AlejandroRuiz444/-nexus32-esp32-pcb/Documentation/CUMPLIMIENTO_REQUISITOS.md

# NEXUS32 — Cumplimiento de requisitos (3/11/2026)

Estado de los 108 requisitos de `planificacion\01_TRAZABILIDAD_requisitos.csv`. **EN DISEÑO** quiere decir que el diseño lo implementa según los documentos de F1 a F3 y **no se re-verificó en esta sesión**; solo CUMPLE lleva una evidencia que se puede citar.

| Estado | Requisitos |
|---|---|
| EN DISEÑO | 64 |
| PARCIAL | 15 |
| CUMPLE | 9 |
| CUMPLE CON EXCEPCIÓN | 9 |
| ABIERTO | 9 |
| NO COMPROBADO | 1 |
| RESUELTO | 1 |
| **Total** | **108** |

| ID | Requisito | Tipo | Estado | Razón o evidencia |
|---|---|---|---|---|
| REQ-001 | El sistema debe poder medir señales procedentes de sensores (§1, p.1) | funcional | **EN DISEÑO** | El diseño lo implementa según 02_ANALISIS_CIRCUITO.md, Q1_esfuerzos.md y las hojas de F3; no re-verificado en esta sesión. ERC: 55 avisos justificados uno a uno (D-18, Q4_erc.md); «0 errores» sin confirmar en el panel Messages |
| REQ-002 | registrar eventos con fecha y hora (§1, p.1) | funcional | **EN DISEÑO** | El diseño lo implementa según 02_ANALISIS_CIRCUITO.md, Q1_esfuerzos.md y las hojas de F3; no re-verificado en esta sesión. ERC: 55 avisos justificados uno a uno (D-18, Q4_erc.md); «0 errores» sin confirmar en el panel Messages |
| REQ-003 | comunicar información tanto por red cableada como por radio (§1, p.1) | funcional | **EN DISEÑO** | El diseño lo implementa según 02_ANALISIS_CIRCUITO.md, Q1_esfuerzos.md y las hojas de F3; no re-verificado en esta sesión. ERC: 55 avisos justificados uno a uno (D-18, Q4_erc.md); «0 errores» sin confirmar en el panel Messages |
| REQ-004 | actuar sobre dos dispositivos externos (§1, p.1) | funcional | **EN DISEÑO** | El diseño lo implementa según 02_ANALISIS_CIRCUITO.md, Q1_esfuerzos.md y las hojas de F3; no re-verificado en esta sesión. ERC: 55 avisos justificados uno a uno (D-18, Q4_erc.md); «0 errores» sin confirmar en el panel Messages |
| REQ-005 | supervisarse localmente (§1, p.1) | funcional | **EN DISEÑO** | P-10 cerrado el 3/11 (orden de pines GND-VCC-SCL-SDA = J3). Solo dependía del cableado; el ERC sigue como verificación |
| REQ-006 | conservar parámetros después de fallos de alimentación (§1, p.1) | funcional | **EN DISEÑO** | El diseño lo implementa según 02_ANALISIS_CIRCUITO.md, Q1_esfuerzos.md y las hojas de F3; no re-verificado en esta sesión. ERC: 55 avisos justificados uno a uno (D-18, Q4_erc.md); «0 errores» sin confirmar en el panel Messages |
| REQ-007 | módulo compacto, modular, mantenible y documentado, apto para la fabricación de una PCB (§ | restricción | **CUMPLE** | Una sola PCB de 159,995 × 119,990 mm, 12 hojas por bloque y documentación en carpetas [VERIFICADO: Gerber GM, NEXUS32.PrjPcb] |
| REQ-008 | El desarrollo debe permitir evaluar cada interfaz digital por separado y posteriormente in | funcional | **CUMPLE** | 23 puntos de prueba (TP1–TP23) y puente de 0 Ω (R55) en la placa [VERIFICADO: PcbDoc y BOM] |
| REQ-009 | diseñar... una tarjeta... basada en ESP32, empleando I²C, SPI y UART (§2, p.1) | funcional | **EN DISEÑO** | El diseño lo implementa según 02_ANALISIS_CIRCUITO.md, Q1_esfuerzos.md y las hojas de F3; no re-verificado en esta sesión. ERC: 55 avisos justificados uno a uno (D-18, Q4_erc.md); «0 errores» sin confirmar en el panel Messages |
| REQ-010 | mediante subsistemas jerárquicos verificables (§2, p.1) | restricción | **EN DISEÑO** | El diseño lo implementa según 02_ANALISIS_CIRCUITO.md, Q1_esfuerzos.md y las hojas de F3; no re-verificado en esta sesión. ERC: 55 avisos justificados uno a uno (D-18, Q4_erc.md); «0 errores» sin confirmar en el panel Messages |
| REQ-011 | Interpretar fichas técnicas y derivar requisitos eléctricos, funcionales y mecánicos (§2.1 | entregable | **PARCIAL** | Las hojas de datos de DS1307 (Analog Devices) y MP1584 rev. 1.1 no se pudieron leer (acceso bloqueado): [PENDIENTE: A1, Fase 1] |
| REQ-012 | Desarrollar esquemáticos jerárquicos con conexiones consistentes y documentación de cada b | entregable | **PARCIAL** | Jerarquía y puertos cerrados en F3 (28/10). ERC: 55 avisos justificados, 0 errores sin confirmar en el panel Messages (D-18) |
| REQ-013 | Implementar periféricos I²C, SPI y UART con asignación de pines y compatibilidad eléctrica | funcional | **EN DISEÑO** | El diseño lo implementa según 02_ANALISIS_CIRCUITO.md, Q1_esfuerzos.md y las hojas de F3; no re-verificado en esta sesión. ERC: 55 avisos justificados uno a uno (D-18, Q4_erc.md); «0 errores» sin confirmar en el panel Messages |
| REQ-014 | Diseñar interfaces analógicas protegidas (§2.1, p.1) | funcional | **EN DISEÑO** | El diseño lo implementa según 02_ANALISIS_CIRCUITO.md, Q1_esfuerzos.md y las hojas de F3; no re-verificado en esta sesión. ERC: 55 avisos justificados uno a uno (D-18, Q4_erc.md); «0 errores» sin confirmar en el panel Messages |
| REQ-015 | alimentación dual (§2.1, p.1) | funcional | **EN DISEÑO** | Condicionado a P-03 (alimentación dual): pregunta al docente abierta; se usa el valor por defecto de 05_PREGUNTAS_DOCENTE.md |
| REQ-016 | conectividad física y dos salidas por relé (§2.1, p.1) | funcional | **EN DISEÑO** | El diseño lo implementa según 02_ANALISIS_CIRCUITO.md, Q1_esfuerzos.md y las hojas de F3; no re-verificado en esta sesión. ERC: 55 avisos justificados uno a uno (D-18, Q4_erc.md); «0 errores» sin confirmar en el panel Messages |
| REQ-017 | Construir librerías completas (§2.1, p.1) | entregable | **CUMPLE CON EXCEPCIÓN** | F2 cerrada: 44 símbolos y 38 huellas con STEP incrustado; desviaciones documentadas D-01 a D-13 (patrones IPC nominales, ranuras, NPTH) |
| REQ-018 | configurar reglas, clases de red/componente y restricciones de ruteo (§2.1, p.1) | entregable | **CUMPLE** | 50 reglas habilitadas [VERIFICADO: pcb_get_design_rules, F5_verificar_gui.py 14/14] y las clases de red (10 propias) y de componente (una por hoja) en el PcbDoc [VERIFICADO: Classes6] |
| REQ-019 | Generar y verificar documentación para fabricación y ensamble: Gerber, perforaciones, BOM  | entregable | **PARCIAL** | BORRADOR en NEXUS32\Manufacturing\BORRADOR_2026-11-03 (Gerber, taladros, IPC-356, STEP, BOM, CPL); el paquete final se genera tras el congelado |
| REQ-020 | Entrada de alimentación desde 24 VDC nominales o batería externa especificada (§3, p.1) | funcional | **EN DISEÑO** | Condicionado a P-03, P-08 y P-11 (preguntas abiertas con valor por defecto) |
| REQ-021 | conversión mediante MP1584EN y regulación adicional (§3, p.1) | funcional | **EN DISEÑO** | Condicionado a P-08: la fuente de 24 V debe ser ≤ 25 V para el OVP del MP1584EN; abierta |
| REQ-022 | Ocho canales analógicos mediante MCP3208 (§3, p.1) | funcional | **EN DISEÑO** | El diseño lo implementa según 02_ANALISIS_CIRCUITO.md, Q1_esfuerzos.md y las hojas de F3; no re-verificado en esta sesión. ERC: 55 avisos justificados uno a uno (D-18, Q4_erc.md); «0 errores» sin confirmar en el panel Messages |
| REQ-023 | cuatro previstos para 0–10 V (§3, p.1) | funcional | **EN DISEÑO** | Condicionado a P-06 (impedancia de entrada y protección de 0–10 V): abierta, con valor por defecto |
| REQ-024 | y cuatro para 0–3,3 V (§3, p.1) | funcional | **EN DISEÑO** | El diseño lo implementa según 02_ANALISIS_CIRCUITO.md, Q1_esfuerzos.md y las hojas de F3; no re-verificado en esta sesión. ERC: 55 avisos justificados uno a uno (D-18, Q4_erc.md); «0 errores» sin confirmar en el panel Messages |
| REQ-025 | con acondicionamiento, filtrado y protección apropiados (§3, p.1) | funcional | **EN DISEÑO** | El diseño lo implementa según 02_ANALISIS_CIRCUITO.md, Q1_esfuerzos.md y las hojas de F3; no re-verificado en esta sesión. ERC: 55 avisos justificados uno a uno (D-18, Q4_erc.md); «0 errores» sin confirmar en el panel Messages |
| REQ-026 | Registro y configuración no volátiles en AT24C256C (§3, p.2) | funcional | **EN DISEÑO** | El diseño lo implementa según 02_ANALISIS_CIRCUITO.md, Q1_esfuerzos.md y las hojas de F3; no re-verificado en esta sesión. ERC: 55 avisos justificados uno a uno (D-18, Q4_erc.md); «0 errores» sin confirmar en el panel Messages |
| REQ-027 | reloj de tiempo real DS1307 con respaldo independiente (§3, p.2) | funcional | **EN DISEÑO** | El diseño lo implementa según 02_ANALISIS_CIRCUITO.md, Q1_esfuerzos.md y las hojas de F3; no re-verificado en esta sesión. ERC: 55 avisos justificados uno a uno (D-18, Q4_erc.md); «0 errores» sin confirmar en el panel Messages |
| REQ-028 | Pantalla OLED SH1106 128×64 mediante I²C y tres pulsadores para navegación de menús (§3, p | funcional | **EN DISEÑO** | P-10 cerrado (orden de pines). La dirección I²C 0x3C es [SUPUESTO]: comprobarla en el módulo físico |
| REQ-029 | Interfaz Ethernet 10BASE-T mediante ENC28J60 (§3, p.2) | funcional | **CUMPLE CON EXCEPCIÓN** | D-48: TPOUT acoplado con meandro; TPIN a 12,1 mm y sin acoplar; 2 violaciones de DiffPairsRouting |
| REQ-030 | comunicación inalámbrica LoRa mediante SX1276 (§3, p.2) | funcional | **EN DISEÑO** | Condicionado a P-05: el Ra-01H no declara FCC/CE; pregunta abierta |
| REQ-031 | Puerto USB-UART mediante CP2102 o variante documentada compatible, para programación, coma | funcional | **EN DISEÑO** | El diseño lo implementa según 02_ANALISIS_CIRCUITO.md, Q1_esfuerzos.md y las hojas de F3; no re-verificado en esta sesión. ERC: 55 avisos justificados uno a uno (D-18, Q4_erc.md); «0 errores» sin confirmar en el panel Messages |
| REQ-032 | Dos salidas independientes por relé con contactos secos y estado seguro definido (§3, p.2) | seguridad | **EN DISEÑO** | Condicionado a P-09 (aislamiento de bobina): abierta, con valor por defecto (optoacoplador PC817X2) |
| REQ-033 | al energizarse inicializa sus buses y verifica la disponibilidad de memoria, reloj, pantal | funcional | **EN DISEÑO** | El diseño lo implementa según 02_ANALISIS_CIRCUITO.md, Q1_esfuerzos.md y las hojas de F3; no re-verificado en esta sesión. ERC: 55 avisos justificados uno a uno (D-18, Q4_erc.md); «0 errores» sin confirmar en el panel Messages |
| REQ-034 | informa el estado por OLED (§4, p.2) | funcional | **EN DISEÑO** | El diseño lo implementa según 02_ANALISIS_CIRCUITO.md, Q1_esfuerzos.md y las hojas de F3; no re-verificado en esta sesión. ERC: 55 avisos justificados uno a uno (D-18, Q4_erc.md); «0 errores» sin confirmar en el panel Messages |
| REQ-035 | lee y procesa periódicamente los canales analógicos; evalúa umbrales e histéresis; actuali | funcional | **EN DISEÑO** | El diseño lo implementa según 02_ANALISIS_CIRCUITO.md, Q1_esfuerzos.md y las hojas de F3; no re-verificado en esta sesión. ERC: 55 avisos justificados uno a uno (D-18, Q4_erc.md); «0 errores» sin confirmar en el panel Messages |
| REQ-036 | registra cambios de estado (§4, p.2) | funcional | **EN DISEÑO** | El diseño lo implementa según 02_ANALISIS_CIRCUITO.md, Q1_esfuerzos.md y las hojas de F3; no re-verificado en esta sesión. ERC: 55 avisos justificados uno a uno (D-18, Q4_erc.md); «0 errores» sin confirmar en el panel Messages |
| REQ-037 | transmite información a través de los medios disponibles (§4, p.2) | funcional | **EN DISEÑO** | El diseño lo implementa según 02_ANALISIS_CIRCUITO.md, Q1_esfuerzos.md y las hojas de F3; no re-verificado en esta sesión. ERC: 55 avisos justificados uno a uno (D-18, Q4_erc.md); «0 errores» sin confirmar en el panel Messages |
| REQ-038 | Definir conectores y rangos reales de entrada de 24 VDC y batería (§5.1, p.2) | funcional | **EN DISEÑO** | Condicionado a P-03 y P-11 (batería y rangos): abiertas |
| REQ-039 | Incluir protecciones, desacoplamiento, filtrado y puntos de prueba (§5.1, p.2) | funcional | **EN DISEÑO** | El diseño lo implementa según 02_ANALISIS_CIRCUITO.md, Q1_esfuerzos.md y las hojas de F3; no re-verificado en esta sesión. ERC: 55 avisos justificados uno a uno (D-18, Q4_erc.md); «0 errores» sin confirmar en el panel Messages |
| REQ-040 | justificar corrientes máximas, consumo de relés y capacidad de regulación (§5.1, p.2) | funcional | **EN DISEÑO** | El diseño lo implementa según 02_ANALISIS_CIRCUITO.md, Q1_esfuerzos.md y las hojas de F3; no re-verificado en esta sesión. ERC: 55 avisos justificados uno a uno (D-18, Q4_erc.md); «0 errores» sin confirmar en el panel Messages |
| REQ-041 | Usar MP1584EN únicamente dentro de sus límites de diseño (§5.1, p.2) | restricción | **EN DISEÑO** | Condicionado a P-08: OVP 26,4–27,75 V frente a 28 V recomendados; abierta |
| REQ-042 | prever sobretensiones/transitorios en redes industriales de 24 V (§5.1, p.2) | seguridad | **EN DISEÑO** | El diseño lo implementa según 02_ANALISIS_CIRCUITO.md, Q1_esfuerzos.md y las hojas de F3; no re-verificado en esta sesión. ERC: 55 avisos justificados uno a uno (D-18, Q4_erc.md); «0 errores» sin confirmar en el panel Messages |
| REQ-043 | Dimensionar alimentación a 3,3 V (§5.1, p.2) | funcional | **EN DISEÑO** | El diseño lo implementa según 02_ANALISIS_CIRCUITO.md, Q1_esfuerzos.md y las hojas de F3; no re-verificado en esta sesión. ERC: 55 avisos justificados uno a uno (D-18, Q4_erc.md); «0 errores» sin confirmar en el panel Messages |
| REQ-044 | reservar despeje de antena si se utiliza ESP32-WROOM con antena integrada (§5.1, p.2) | regla de ubicación | **PARCIAL** | Recorte de L2/L3 en x 31–66 × y 113,3–120 mm bajo la antena y SW1 se queda; los ≥ 15 mm libres no se han medido y la cota es [SUPUESTO] ([PENDIENTE: A1, Fase 4]) |
| REQ-045 | Implementar circuitos de arranque, EN/RESET y BOOT (§5.1, p.2) | funcional | **EN DISEÑO** | El diseño lo implementa según 02_ANALISIS_CIRCUITO.md, Q1_esfuerzos.md y las hojas de F3; no re-verificado en esta sesión. ERC: 55 avisos justificados uno a uno (D-18, Q4_erc.md); «0 errores» sin confirmar en el panel Messages |
| REQ-046 | generar una matriz de asignación de GPIO (§5.1, p.2) | entregable | **EN DISEÑO** | El diseño lo implementa según 02_ANALISIS_CIRCUITO.md, Q1_esfuerzos.md y las hojas de F3; no re-verificado en esta sesión. ERC: 55 avisos justificados uno a uno (D-18, Q4_erc.md); «0 errores» sin confirmar en el panel Messages |
| REQ-047 | Memoria AT24C256C para identificación, parámetros, umbrales y registro de eventos según ma | funcional | **EN DISEÑO** | El diseño lo implementa según 02_ANALISIS_CIRCUITO.md, Q1_esfuerzos.md y las hojas de F3; no re-verificado en esta sesión. ERC: 55 avisos justificados uno a uno (D-18, Q4_erc.md); «0 errores» sin confirmar en el panel Messages |
| REQ-048 | Reloj DS1307 con cristal de 32,768 kHz y batería de respaldo, conforme a su hoja de datos  | funcional | **EN DISEÑO** | Revisión del datasheet DS1307 [PENDIENTE: A1, Fase 1] |
| REQ-049 | Identificar y justificar direcciones I²C, pull-ups, resistencia equivalente y compatibilid | funcional | **EN DISEÑO** | El diseño lo implementa según 02_ANALISIS_CIRCUITO.md, Q1_esfuerzos.md y las hojas de F3; no re-verificado en esta sesión. ERC: 55 avisos justificados uno a uno (D-18, Q4_erc.md); «0 errores» sin confirmar en el panel Messages |
| REQ-050 | Considerar expresamente que DS1307 funciona con alimentación principal cercana a 5 V y que | seguridad | **EN DISEÑO** | Revisión pendiente [PENDIENTE: A1, Fase 1]; cálculo de niveles en 02_ANALISIS_CIRCUITO.md |
| REQ-051 | Distinguir respaldo del reloj RTC de la alimentación general del equipo (§5.2, p.2) | funcional | **EN DISEÑO** | El diseño lo implementa según 02_ANALISIS_CIRCUITO.md, Q1_esfuerzos.md y las hojas de F3; no re-verificado en esta sesión. ERC: 55 avisos justificados uno a uno (D-18, Q4_erc.md); «0 errores» sin confirmar en el panel Messages |
| REQ-052 | Integrar pantalla 128×64 compatible con controlador SH1106 y especificar su modalidad físi | funcional | **EN DISEÑO** | P-10 cerrado: cabezal 1×4 hembra con orden confirmado. Falta la inspección con el módulo real (cotejar su serigrafiado antes de conectarlo) |
| REQ-053 | Validar tensión de alimentación, nivel lógico I²C, asignación de conectores y representaci | funcional | **ABIERTO** | P-10 abierto por (1) que el módulo concreto admita 3,3 V [PENDIENTE: estudiante] y (2) la huella y la zona libre dependen de las cotas del módulo, sin medir |
| REQ-054 | Usar MCP3208 de 12 bits y ocho canales; distribuir cuatro entradas acondicionadas de 0–10  | funcional | **EN DISEÑO** | El diseño lo implementa según 02_ANALISIS_CIRCUITO.md, Q1_esfuerzos.md y las hojas de F3; no re-verificado en esta sesión. ERC: 55 avisos justificados uno a uno (D-18, Q4_erc.md); «0 errores» sin confirmar en el panel Messages |
| REQ-055 | Justificar divisor/etapa de adaptación, impedancia, filtrado RC, protección y referencia d | funcional | **EN DISEÑO** | El diseño lo implementa según 02_ANALISIS_CIRCUITO.md, Q1_esfuerzos.md y las hojas de F3; no re-verificado en esta sesión. ERC: 55 avisos justificados uno a uno (D-18, Q4_erc.md); «0 errores» sin confirmar en el panel Messages |
| REQ-056 | Evitar inyectar señales fuera de los límites admisibles del ADC (§5.4, p.3) | seguridad | **EN DISEÑO** | El diseño lo implementa según 02_ANALISIS_CIRCUITO.md, Q1_esfuerzos.md y las hojas de F3; no re-verificado en esta sesión. ERC: 55 avisos justificados uno a uno (D-18, Q4_erc.md); «0 errores» sin confirmar en el panel Messages |
| REQ-057 | Integrar ENC28J60 con reloj, magnetics, conector RJ45 y periféricos requeridos por datashe | funcional | **EN DISEÑO** | El diseño lo implementa según 02_ANALISIS_CIRCUITO.md, Q1_esfuerzos.md y las hojas de F3; no re-verificado en esta sesión. ERC: 55 avisos justificados uno a uno (D-18, Q4_erc.md); «0 errores» sin confirmar en el panel Messages |
| REQ-058 | Prever protección ESD y LEDs de enlace/actividad si son soportados por la implementación ( | funcional | **EN DISEÑO** | El diseño lo implementa según 02_ANALISIS_CIRCUITO.md, Q1_esfuerzos.md y las hojas de F3; no re-verificado en esta sesión. ERC: 55 avisos justificados uno a uno (D-18, Q4_erc.md); «0 errores» sin confirmar en el panel Messages |
| REQ-059 | Incorporar SX1276 mediante módulo RF aprobado o solución discreta suficientemente justific | funcional | **EN DISEÑO** | Condicionado a P-05: módulo Ra-01H sin FCC/CE declarado |
| REQ-060 | Incluir SPI, Chip Select, reset, interrupciones, alimentación de bajo ruido y antena/conec | funcional | **EN DISEÑO** | El diseño lo implementa según 02_ANALISIS_CIRCUITO.md, Q1_esfuerzos.md y las hojas de F3; no re-verificado en esta sesión. ERC: 55 avisos justificados uno a uno (D-18, Q4_erc.md); «0 errores» sin confirmar en el panel Messages |
| REQ-061 | Integrar CP2102/variante seleccionada con USB y UART del ESP32 para configuración y depura | funcional | **EN DISEÑO** | El diseño lo implementa según 02_ANALISIS_CIRCUITO.md, Q1_esfuerzos.md y las hojas de F3; no re-verificado en esta sesión. ERC: 55 avisos justificados uno a uno (D-18, Q4_erc.md); «0 errores» sin confirmar en el panel Messages |
| REQ-062 | Prever conexión TX/RX, niveles lógicos, protección ESD, identificación de pines y conector | funcional | **EN DISEÑO** | El diseño lo implementa según 02_ANALISIS_CIRCUITO.md, Q1_esfuerzos.md y las hojas de F3; no re-verificado en esta sesión. ERC: 55 avisos justificados uno a uno (D-18, Q4_erc.md); «0 errores» sin confirmar en el panel Messages |
| REQ-063 | Usar USB-C, D+/D− como par diferencial (§5.7, p.3) | funcional | **CUMPLE CON EXCEPCIÓN** | Par USB 655,65 mil sin acoplar frente a 500 (D-57); 3 vías en USB_DN y D-60 (la herramienta marca 2 de 3); D-51 y D-53 |
| REQ-064 | Disponer de dos salidas independientes con contactos COM/NO/NC según referencia elegida (§ | funcional | **EN DISEÑO** | El diseño lo implementa según 02_ANALISIS_CIRCUITO.md, Q1_esfuerzos.md y las hojas de F3; no re-verificado en esta sesión. ERC: 55 avisos justificados uno a uno (D-18, Q4_erc.md); «0 errores» sin confirmar en el panel Messages |
| REQ-065 | Estructura sugerida de hojas en un único proyecto NEXUS32.PrjPcb: 00_TOP_LEVEL … 11_DIGITA | entregable | **CUMPLE** | Las 12 hojas 00_TOP_LEVEL a 11_DIGITAL_OUTPUTS están en NEXUS32.PrjPcb con sus nombres finales [VERIFICADO: NEXUS32.PrjPcb] |
| REQ-066 | NEXUS32.PcbDoc y carpetas Libraries / Documentation / Manufacturing (§6, p.4) | entregable | **CUMPLE** | NEXUS32.PcbDoc y las carpetas Libraries, Documentation y Manufacturing existen [VERIFICADO: árbol de archivos] |
| REQ-067 | Es obligatorio usar Sheet Symbols, Sheet Entries, Ports, Net Labels y designadores coheren | restricción | **EN DISEÑO** | El diseño lo implementa según 02_ANALISIS_CIRCUITO.md, Q1_esfuerzos.md y las hojas de F3; no re-verificado en esta sesión. ERC: 55 avisos justificados uno a uno (D-18, Q4_erc.md); «0 errores» sin confirmar en el panel Messages |
| REQ-068 | No está permitido reemplazar la jerarquía por un esquemático plano de gran tamaño (§6, p.4 | restricción | **EN DISEÑO** | El diseño lo implementa según 02_ANALISIS_CIRCUITO.md, Q1_esfuerzos.md y las hojas de F3; no re-verificado en esta sesión. ERC: 55 avisos justificados uno a uno (D-18, Q4_erc.md); «0 errores» sin confirmar en el panel Messages |
| REQ-069 | ni entregar carpetas de históricos y archivos temporales como parte de la entrega final (§ | restricción | **ABIERTO** | Hoy hay History\, Project Logs for NEXUS32\, Project Outputs for NEXUS32\, NEXUS32.canvas.json y 7 hojas NEXUS32__*.SchDoc sueltas en la carpeta: se limpian al empaquetar la entrega, no antes del congelado |
| REQ-070 | Ubicar desacoplamientos próximos a los pines correspondientes (§7, p.4) | regla de ubicación | **PARCIAL** | Desacoplo a pines de CI: mediana 2,5 mm y máximo 6,3 mm frente al ≤ 3 mm [SUPUESTO] (D-30; 3 condensadores en el único pin 3V3 del ESP32) |
| REQ-071 | controlar los bucles de potencia del MP1584EN (§7, p.4) | regla de ubicación | **EN DISEÑO** | El diseño lo implementa según 02_ANALISIS_CIRCUITO.md, Q1_esfuerzos.md y las hojas de F3; no re-verificado en esta sesión. ERC: 55 avisos justificados uno a uno (D-18, Q4_erc.md); «0 errores» sin confirmar en el panel Messages |
| REQ-072 | Mantener zonas de protección y separaciones adecuadas entre potencia, RF, Ethernet, adquis | regla de ubicación | **PARCIAL** | DRC de separaciones: 0 violaciones [VERIFICADO: DRC por grupos 13:12]; la zona de ≥ 1,0 mm entre contactos y lógica [SUPUESTO] no se midió aparte |
| REQ-073 | Preservar plano de referencia continuo; evitar cortes bajo señales críticas (§7, p.4) | regla de ubicación | **CUMPLE CON EXCEPCIÓN** | L2 = GND continuo con planos conectados (D-54). pcb_check_ground da un falso positivo (no modela los planos); 152 de 161 vías de señal sin vía de retorno a 50 mil (D-53) |
| REQ-074 | Realizar ruteo diferencial donde corresponda (USB y Ethernet) (§7, p.4) | regla de ubicación | **CUMPLE CON EXCEPCIÓN** | Pares USB y Ethernet ruteados; excepciones D-48 y D-57 (3 violaciones de DiffPairsRouting) |
| REQ-075 | y línea de impedancia simple para RF (§7, p.4) | regla de ubicación | **EN DISEÑO** | Regla W_RF_50R (13/14/15 mil) y DRC de anchos con 0 violaciones [VERIFICADO]; la longitud no se re-midió |
| REQ-076 | Mantener despejes de antena y orientación física de OLED, RJ45, conectores y relés (§7, p. | regla de ubicación | **ABIERTO** | P-10: depende de la orientación y la ubicación física del módulo OLED y de la inspección 3D, no del orden de pines |
| REQ-077 | Incorporar puntos de prueba para alimentación y buses y referencias legibles de serigrafía | regla de ubicación | **CUMPLE** | 23 puntos de prueba en la placa [VERIFICADO: PcbDoc]; la lista completa de 02 §1.8 no se re-comprobó |
| REQ-078 | Resolver violaciones DRC antes de liberar fabricación (§7, p.4) | restricción | **CUMPLE CON EXCEPCIÓN** | No son 0 violaciones: DRC completo sin serigrafía = 16 (DiffPairsRouting 3 y UnRoutedNet 13) más serigrafía 136 y 140. Aceptadas D-46, D-48, D-52, D-56 a D-58 y D-64 |
| REQ-079 | Símbolo esquemático completo con pines, nombres, direcciones y designador correctos (§8, p | entregable | **EN DISEÑO** | P2_redes: 658 de 658 pines con pad y red correctos, 128 redes [VERIFICADO 3/11]; el resto del criterio (símbolo completo) es de F2 |
| REQ-080 | Footprint correspondiente a la referencia y variante exacta de encapsulado (§8, p.5) | entregable | **CUMPLE CON EXCEPCIÓN** | Huellas de F2 con desviaciones D-01 a D-13 y huella de MH como componente (D-27) |
| REQ-081 | Modelo 3D STEP o equivalente dimensionado y orientado (§8, p.5) | entregable | **PARCIAL** | 193 de 220 piezas con cuerpo 3D (pcb_check_3d PASS); sin cuerpo MH1–MH4 y TP1–TP23; aviso de orientación en D5, D10 y D11 [PENDIENTE: revisión visual]. Riesgo R-05 |
| REQ-082 | Proyecto Altium: PrjPcb, SchDoc, PcbDoc y librerías necesarias para abrir sin vínculos rot | entregable | **NO COMPROBADO** | No se ha abierto el proyecto desde una copia en otra carpeta; [PENDIENTE] al empaquetar |
| REQ-083 | PCB 3D: ensamble visible con conectores, RJ45, OLED, relés y radio (§9, p.5) | entregable | **PARCIAL** | STEP de 53,5 MB generado en el borrador; la captura de la vista 3D de Altium está pendiente |
| REQ-084 | Gerber + drill acordes a stack-up y revisión de visor de fabricación (§9, p.5) | entregable | **PARCIAL** | Gerber (11 archivos) y taladros (429 agujeros) en el borrador; chequeo offline hecho; revisión en visor de Gerber [PENDIENTE] |
| REQ-085 | BOM: Comment, Designator, Footprint, Supplier part (§9, p.5) | entregable | **PARCIAL** | BOM_JLCPCB.csv: 80 líneas, 50 con código LCSC (123 de 193 componentes), 30 [PENDIENTE] |
| REQ-086 | CPL / Pick and Place: Designator, Mid X, Mid Y, Layer, Rotation (§9, p.5) | entregable | **PARCIAL** | CPL_JLCPCB.csv: 193 componentes, mm y grados; rotaciones y polaridad de BT1 por comprobar en la vista previa de JLCPCB |
| REQ-087 | Se deberá validar la disponibilidad exacta de cada referencia (§9, p.5) | entregable | **PARCIAL** | Consulta de stock del 3/11 para 73 códigos (3 con bajada de al menos el 50 % desde el 25/10); la consulta del día del pedido está pendiente; 81 de 81 líneas con código, 4 de ellas (R1, R2, R3 y 43,2 kΩ al 0,1 %) con umbral de stock bajado (D-68) |
| REQ-088 | decidir qué componentes se montarán en fábrica y cuáles serán de inserción o montaje poste | entregable | **ABIERTO** | P-07 (qué se ensambla en fábrica): abierta; el módulo OLED y el montaje posterior no son piezas de JLCPCB |
| REQ-089 | El MP1584EN no sustituye el diseño de protección de una entrada industrial expuesta a tran | seguridad | **EN DISEÑO** | El diseño lo implementa según 02_ANALISIS_CIRCUITO.md, Q1_esfuerzos.md y las hojas de F3; no re-verificado en esta sesión. ERC: 55 avisos justificados uno a uno (D-18, Q4_erc.md); «0 errores» sin confirmar en el panel Messages |
| REQ-090 | DS1307 necesita dominio de alimentación apropiado (§10, p.5) | seguridad | **EN DISEÑO** | Revisión pendiente [PENDIENTE: A1, Fase 1] |
| REQ-091 | no debe aplicarse tensión de 5 V a GPIO de ESP32 (§10, p.5) | seguridad | **EN DISEÑO** | El diseño lo implementa según 02_ANALISIS_CIRCUITO.md, Q1_esfuerzos.md y las hojas de F3; no re-verificado en esta sesión. ERC: 55 avisos justificados uno a uno (D-18, Q4_erc.md); «0 errores» sin confirmar en el panel Messages |
| REQ-092 | La interfaz Ethernet física y los requisitos de RF se deben implementar conforme a referen | seguridad | **EN DISEÑO** | El diseño lo implementa según 02_ANALISIS_CIRCUITO.md, Q1_esfuerzos.md y las hojas de F3; no re-verificado en esta sesión. ERC: 55 avisos justificados uno a uno (D-18, Q4_erc.md); «0 errores» sin confirmar en el panel Messages |
| REQ-093 | La bobina de relé requiere aislamiento optoacoplado (§10, p.5) | seguridad | **EN DISEÑO** | Condicionado a P-09: PC817X2 entre GPIO y bobina; abierta |
| REQ-094 | sus contactos no deben utilizarse para cargas peligrosas en prácticas sin autorización (§1 | seguridad | **ABIERTO** | No hay registro de la serigrafía de advertencia ni de la nota de uso ≤ 30 VDC y 1 A (D-50) en el README final [PENDIENTE] |
| REQ-095 | La fabricación y el ensamble están sujetos a revisión real de JLCPCB, no a supuestos de di | seguridad | **ABIERTO** | Requiere la cuenta y el pedido del estudiante en JLCPCB (revisión de ingeniería) |
| REQ-096 | PCB de 160 mm × 120 mm (§11, p.6) | restricción | **CUMPLE** | Contorno de 159,995 × 119,990 mm [VERIFICADO: Gerber GM y PcbDoc] |
| REQ-097 | cuatro agujeros de montaje en las esquinas (figura §11, p.6) | restricción | **PARCIAL** | 4 agujeros M3 simétricos a 7,49 mm de los bordes (MH1–MH4, D-27); las cotas son [SUPUESTO] ([PENDIENTE: docente/estudiante]) |
| REQ-098 | zonas por bloque según la figura: ESP32 CORE/I²C, LoRa+RF, POWER, SPI+ADC, RELÉS, ETHERNET | regla de ubicación | **ABIERTO** | P-10: la figura no ubica la OLED ni los pulsadores; las zonas son una decisión de colocación (D-30, ±3 mm), no el orden de pines |
| REQ-099 | Todos los componentes deberán estar alineados y agrupados por bloque funcional (§12.1, p.6 | regla de ubicación | **EN DISEÑO** | El diseño lo implementa según 02_ANALISIS_CIRCUITO.md, Q1_esfuerzos.md y las hojas de F3; no re-verificado en esta sesión. ERC: 55 avisos justificados uno a uno (D-18, Q4_erc.md); «0 errores» sin confirmar en el panel Messages |
| REQ-100 | Los conectores deberán estar orientados hacia el borde para facilitar acceso y cableado (§ | regla de ubicación | **ABIERTO** | Sin inspección registrada; la orientación de J4 y J5 es [SUPUESTO] y falta la captura lateral del estudiante |
| REQ-101 | La OLED deberá quedar libre de interferencias mecánicas (§12.3, p.6) | regla de ubicación | **ABIERTO** | P-10: la altura libre de ≥ 6 mm y la huella dependen de las cotas y la ubicación del módulo, sin medir |
| REQ-102 | Los designadores serán visibles, legibles y no se superpondrán con pads (§12.4, p.6) | regla de ubicación | **CUMPLE CON EXCEPCIÓN** | Serigrafía: 136 filas contra serigrafía y 140 contra máscara (57 designadores y 14 arcos); D-62, D-63 y D-64. 9 designadores (MH1, MH2, MH4, U6, J2, J4, J5, J8, J9) quedan fuera del contorno de la placa |
| REQ-103 | Se deberán incorporar puntos de prueba en 24 V, 5 V, 3.3 V, GND y señales de depuración im | regla de ubicación | **CUMPLE** | 23 puntos de prueba en la placa [VERIFICADO]; la lista completa de 02 §1.8 no se re-comprobó |
| REQ-104 | Todos los componentes deberán tener su modelo 3D (§12.6, p.6) | regla de ubicación | **PARCIAL** | 27 piezas sin cuerpo 3D (MH1–MH4 y TP1–TP23, a propósito: D-09 y D-27); riesgo R-05 |
| REQ-105 | Se crearán Net Classes, Component Classes y Differential Pair Classes (§12.7, p.6) | regla de ubicación | **PARCIAL** | 10 clases de red propias y una clase de componente por hoja en el PcbDoc [VERIFICADO: Classes6]; la clase de pares diferenciales no se re-comprobó |
| REQ-106 | No se admitirá autoruteo (§12.8, p.6) | restricción | **RESUELTO** | P-01: el docente autorizó el autoruteo de palabra el 26/10 (sin constancia escrita); el §12.8 del PDF sigue diciendo lo contrario |
| REQ-107 | El docente autorizó el uso de autoruteo (hecho confirmado por el estudiante; sin constanci | restricción | **CUMPLE** | route_plan (A* offline) usado en los grupos no críticos, con ruteo guiado en USB, Ethernet y RF [VERIFICADO: F5] |
| REQ-108 | La PCB deberá pasar DRC antes de generar archivos de fabricación (§12.9, p.6) | restricción | **CUMPLE CON EXCEPCIÓN** | Borrador generado con el DRC de 16 violaciones y la serigrafía de arriba, todas con excepción documentada; el paquete final solo tras el congelado y un DRC final |
