AlejandroRuiz444/-nexus32-esp32-pcb/Documentation/DESVIACIONES.md

# NEXUS32 — Desviaciones y recortes documentados (M2)

Marcas: [VERIFICADO: evidencia] · [SUPUESTO] · [PENDIENTE: dueño]. Fechas HPS (UTC-5).

## F2 — Librerías (2026-10-26/27)

| # | Desviación / recorte | Motivo | Impacto | Estado |
|---|---|---|---|---|
| D-01 | **Pasivos con patrón IPC-7351B nominal** (R/C/LED 0603, C 0805, C 1210, diodo SOD-123): sin patrón de soldadura en hoja de datos (KiCad `R_0603_1608Metric`, `C_0805_2012Metric`, `C_1210_3225Metric`, `D_SOD-123`). Recorte (a) del prompt M2. | Los fabricantes de pasivos no publican patrón; el estándar de la industria es IPC-7351B. | Ninguno para JLCPCB (huellas habituales de la propia JLC). | Aceptado |
| D-02 | **SOP-4 del PC817X2CSP9F**: la hoja de Sharp (p.4/11) solo da el contorno (cuerpo 6.5×4.6, paso 2.54, L 10.16±0.3, pie 1.0±0.25, ancho 1.2±0.3). Pad = IPC-7351B nominal gullwing (JT=JH=0.35, JS=0.03): 2.26×1.58 a ±4.4575. | Sin patrón en hoja. | `lib_audit_footprint_vs_datasheet` no aplicable. | Aceptado |
| D-03 | **Ra-01H**: Ai-Thinker (p.9) da 16×17, paso 2.0, pad del módulo 1.2×1.2, pin 1 a 1.5 del extremo, pero no patrón de soldadura. Pad de huella 1.95×1.2 (1.2 bajo el módulo + 0.75 hacia fuera). | Sin patrón en hoja. | Misma consideración que D-02. | Aceptado |
| D-04 | **USB-C TYPE-C-31-M-12**: las 4 patas de blindaje son ranuras chapadas (agujero 0.6×1.7 arriba y 0.6×1.4 abajo, anillo 0.9×2.0 / 0.9×1.7) y los 2 pivotes son agujeros NPTH Ø0.6. Ningún handler del puente escribe `HoleType`/slot ni `Plated` (solo lectura; `obj_modify` en PCB solo admite HoleSize/TopXSize/TopYSize…; el propio código lo advierte: «Edit the hole shape by hand»). Se crearon como agujero redondo PTH Ø0.61 con anillo oblongo (`roundrect` 50 %) y pivotes con anillo Ø0.71. | Limitación de la API. | Sin la corrección el conector no se monta (la pata de 1.4–1.7 mm no entra en un agujero de 0.6). | **CERRADO 2026-10-27 17:41.** Las 4 ranuras las hizo el estudiante en la GUI (Hole *Slot*, ancho 0.61, rotación 90°, longitud 1.7 en los 2 óvalos 0.9×2.0 y 1.4 en los 2 de 0.9×1.7). Los 2 pivotes (x=±2.8956 mm, y=+1.4478 mm respecto a la referencia) pasaron a NPTH con la herramienta nueva `lib_set_pad_props` (ver D-13). Verificado con `lib_get_pad_geometry`: 4 `hole_type:slot` (0.6096 × 1.69999914 / 1.39999974, `plated:true`), 2 pivotes `plated:false`, simetría ±4.318 mm exacta; `lib_validate_footprint` PASS. |
| D-05 | **RJ45 HR911105A**: 2 guías NPTH Ø3.25 aproximadas como PTH Ø3.40 (mismo motivo que D-04). | Limitación de la API. | Agujero chapado en lugar de no chapado: el pad SH queda unido al blindaje (inocuo si SH va al plano de GND/chasis); verificar en DRC mecánico. | **CERRADO 2026-10-27 17:41** con `lib_set_pad_props`: los 2 pads SH grandes (Ø4.191, x=±5.715 mm, y=+1.9304 mm respecto a la referencia) quedaron como agujero **redondo 3.25 mm NPTH** (`hole_mm` 3.25000112, `plated:false`); los 2 SH de Ø2.59 (patas de blindaje) siguen chapados. Verificado con `lib_get_pad_geometry`; `lib_validate_footprint` PASS. |
| D-13 | **Herramienta nueva del puente `lib_set_pad_props`** (cambia hueco, ranura, rotación de ranura, *Plated* y posición de pads ya existentes en una PcbLib). Desvía la regla dura del prompt M2 «no modifiques eda-agent ni los .pas, no despliegues handlers»: **autorización escrita del usuario 2026-10-27** («usted cree una tool si no existe pero metale usted»). Pascal `Lib_SetPadProps` en `Library.pas` (comando `library.set_pad_props`), `SCRIPT_VERSION` 2026.10.27.1; Python en `tools/library.py`; prueba `tests/test_lib_set_pad_props.py`. | Ninguna tool podía quitar *Plated* ni corregir un pad ya creado; la edición a mano en la GUI tuvo tres incidencias (un pad arrastrado a la rejilla de 5 mil, un Ctrl+S que no llegó a guardar el archivo, un hueco cambiado a Slot por error). | Solo edita pads de huellas de una PcbLib (no de una PcbDoc): en F4 los 4 taladros M3 se harán como una huella `MH_M3` en la librería, con el agujero NPTH puesto por esta herramienta, y se colocarán en la placa. Seguridad: selector por nombre y/o posición, `expect` aborta sin cambiar nada, `dry_run`. Sin commits (regla mantenida). Respaldo previo en `_respaldos\eda-agent_pre-set_pad_props_2026-10-27_1141`. | Cerrado: desplegado 17:38 (script 2026.10.27.1, `version_match:true`), 4 pads editados y verificados. La herramienta aún no está en la lista de tools del MCP hasta recargar la ventana de VS Code; se usa por `F2_padprops_driver.py`. |
| D-06 | **Dos huellas SOT-23-6** (una por pieza): SRV05-4 (Semtech p.11: pad 0.60×1.10, filas a ±1.25) y USBLC6-2SC6 (ST p.12 Fig.22: pad 0.60×1.20, filas a ±1.15). | Cada fabricante recomienda un patrón distinto para el mismo contorno. | Dos huellas en lugar de una; ambas con su fuente. | Aceptado |
| D-07 | **37 modelos STEP de EasyEDA/LCSC** (modelos de la comunidad, no del fabricante), descargados por uuid de huella y **recolocados** con `F2_step_fit.py` (giro de 90°·k y traslación para que los pies caigan sobre los pads; USB-C fijado a mano con colas, patas y pivotes medidos en el modelo). Tamaño real de cuerpo coherente con la hoja (p.ej. SOT-23-5 3.0×2.9, ESP32 18×25.5, USB-C cara frontal a 0.49 mm del borde de placa). | No hay STEP oficial para todas las piezas. | Dimensiones 3D aproximadas (±0.1 mm típico). | Aceptado |
| D-08 | **Origen de las huellas = centro del bbox de pads** y geometría desplazada +2000 mil: `lib_link_3d_model` coloca el modelo en el (0,0) absoluto de la librería y deja la referencia de la huella en (2000,2000) mil [VERIFICADO: ZZ_TEST_A/B + las 38 colocadas en placa de pruebas]. | Evitar que el cuerpo 3D quede 50.8 mm desplazado de los pads. | Ninguno; el punto de colocación coincide con el centro de pads. | Cerrado |
| D-09 | **TP_PAD_1.5mm** (punto de prueba): pad redondo desnudo 1.5 mm sin pieza (DEC-024), sin modelo 3D. | No se ensambla. | En F7 hay que excluir los TP del BOM/CPL. | Aceptado |
| D-10 | Parámetros de librería **fabricante, MPN y código LCSC** para las 38 piezas con código propio (`Supplier Part Number 1` y `LCSC Part #`); los pasivos genéricos (RES/CAP/LED) reciben valor y código en F3 por instancia. | BOM JLCPCB. | — | Cerrado |
| D-11 | Módulo OLED: cabezal hembra 1×4 con orden GND-VCC-SCL-SDA; el orden real se confirma al comprar el módulo. | Sin módulo elegido. | Posible reasignación de 2 pines. | **CERRADO por el estudiante (2026-11-01, v5):** acepta el orden GND-VCC-SCL-SDA con la mitigación de serigrafía: rotular claramente cada pin de J3 (GND, 3V3, SCL, SDA) y la nota «verificar el orden del módulo antes de enchufar», que también va en la documentación de entrega (README de Manufacturing). Pendiente de él (no bloquea): confirmar el orden de pines de su módulo. **[PENDIENTE de ejecución: rotular J3 en la serigrafía cuando se escriba en Altium]** **CERRADO el 3/11/2026 (P-10, orden de pines):** el estudiante aportó la descripción de su módulo OLED SH1106: 1 GND, 2 VCC (3,3 V o 5 V según el módulo), 3 SCL, 4 SDA. Coincide 1 a 1 con J3 del tablero: pad 1 GND, pad 2 V3V3, pad 3 SCL, pad 4 SDA (leído tras el ECO en `P2_pads.json` y comprobado por Claude de la GUI en el archivo guardado c5b9517e). **Orden confirmado con la descripción del estudiante; falta cotejarlo con el serigrafiado físico del módulo antes de conectarlo; si no coincidiera, se corrige con un cable que cruce los hilos, sin cambiar el PCB.** El tablero entrega 3,3 V en el pin 2: el módulo concreto debe admitir 3,3 V [PENDIENTE: comprobarlo en el módulo físico; el SH1106 solo da el rango del controlador]. **[APLICADO]** Los rótulos GND, 3V3, SCL y SDA de J3 y la nota «VERIFICAR ORDEN / ANTES DE ENCHUFAR» están en la placa y se quedan; solo se moverían si el paso B de serigrafía lo necesitara. Sin cambios en la placa por este cierre. |
| D-12 | Portapilas BAT-HLD-001: polaridad (+ pestañas laterales, − pad central) [SUPUESTO con soporte de EasyEDA]. | La hoja no rotula el pad. | Comprobar con la vista previa de JLCPCB. | **CERRADO por el estudiante (2026-11-01, v5):** acepta BT1 con + en las lengüetas laterales y − en el pad central; el plano de TE marca el «+» en la lengüeta superior; el error solo haría que el RTC pierda la hora, sin daño. **[SUPUESTO con soporte del plano]**. Pendiente de él (no bloquea): comprobar la polaridad de BT1 en la vista previa de JLCPCB. |

## F3 — Esquemáticos (2026-10-27/28)

| # | Desviación / recorte | Motivo | Impacto | Estado |
|---|---|---|---|---|
| D-14 | **Tamaño de hoja**: 01, 02, 03, 07, 08, 10, 11 y 00 en A3; 04, 05, 06 y 09 en A4. Bloque de datos del estudiante (nombre, logo UTP, Rev 1.0, fecha, hoja n/12) dibujado a mano abajo a la derecha en cada hoja con el título de Altium desactivado. | El ejecutor `design_execute_plan` crea siempre hojas A4 `NEXUS32__<hoja>.SchDoc`; se fijó el tamaño con `sch_set_sheet_size`, se renombró al nombre final con el proyecto cerrado y se editaron solo las líneas `DocumentPath=` del `.PrjPcb` guardado por Altium. | Ninguno funcional. | Cerrado |
| D-15 | **Puertos de hoja con cable corto**: 8 puertos de 7 redes (CS_ENC, INT_ENC, RST_ENC, RST_LORA en 2 hojas, BTN_UP/DOWN/OK) se conectan con un cable desde el extremo IZQUIERDO del puerto hasta el pin (el cable queda bajo el cuerpo del puerto). | Altium reajusta el ancho del puerto al texto al cargar (656 mil vivo, 650 guardado en el archivo): el extremo derecho nunca cae exacto sobre el pin. Causa confirmada leyendo los `.SchDoc` guardados (`F3_puertos_schdoc.py`). | Feo pero equivalente; se limpia al final (bloque de limpieza). | Cerrado, limpieza pendiente |
| D-16 | **Tipos de E/S**: los 11 puertos de hojas hijas pegados a un pin de tipo IO (GPIO del ESP32, DIO del Ra-01H) y sus entradas de hoja en 00_TOP_LEVEL son *bidireccionales*. | Altium (ERC «Nets with possible connection problems») marca un puerto de salida/entrada pegado a un pin IO. | La dirección de la señal se lee del nombre, no de la flecha. | Cerrado |
| D-17 | **SRV05-4 pin 5 sin conexión** (NoERC) y pines MODE y SHDN del TPS26600 abiertos a propósito (MODE abierto = auto-reintento; SHDN con pull-up interno a 2.7 V típ.) [TPS2660x p.7, p.17]. | Hojas de datos. | El ERC los lista como «floating input pins» aunque haya NoERC colocado (el NoERC no los silencia en este proyecto; ver Q4). | Abierto: Q4 |
| D-18 | **ERC**: 55 avisos tras F3 (34 «nets with no driving source» en redes analógicas/pasivas, 17 fuera de rejilla, 4 por MODE/SHDN). La severidad no la expone el puente. | Ver Q4. | No se afirma «0 errores» hasta ver el panel Messages. | [PENDIENTE: estudiante, Q4] |

## Q — Bloque de calidad previo al ECO (2026-10-29)

Evidencia: `planificacion\evidencia\Q1_esfuerzos.md` (154 filas), `Q3_revision_diseno.md` (33 filas); datos de las piezas nuevas en `Q1_buscar.py` (consultas al catálogo de JLCPCB/LCSC del 2026-10-29).

| # | Cambio | Motivo (caso peor, con cifras) | Impacto | Estado |
|---|---|---|---|---|
| D-19 | **D1, D2, D4: SS54 (40 V) → SS56 (60 V, SMA, hongjiacheng, C18199169, preferida, stock 1.16 M)**. Mismo encapsulado SMA/D_SMA y mismos pines A/K. | D1: con J1 invertido y bateria de 12 V conectada la inversa llega a 15+28 = 43 V; D2: con un pico de 45.4 V (Vc de la SMBJ28A) sin bateria; D4: 1.5 × 27.8 V = 41.7 V > 40 V. | +0.15 V de caída directa (0.7 V a 5 A, irrelevante a 0.4-0.7 A). Pieza «extendida» (cargo de preparación de JLCPCB). | **Aplicado en los esquemáticos** (verificado el 3/11 en los `.SchDoc` guardados: D1 y D2 en `01_INPUT_POWER.SchDoc`, D4 en `02_POWER_REGULATION.SchDoc`, con LibReference, Comment y Manufacturer Part Number = SS56). Ver D-67. |
| D-20 | **C9, C10: 22 µF 10 V → 22 µF 16 V** (CL21A226MOQNNNE, C98190, 0805, mismo footprint). **C11, C58: 10 µF 10 V 0603 → 10 µF 16 V 0805** (CL21A106KOQNNNE, C1713, huella C_0805). | Regla del bloque Q1: riel de 5 V → condensadores ≥ 16 V; además a 5.2 V las piezas de 10 V pierden ~45-55 % de capacidad (X5R) y la compensación del MP1584 (Tabla 3) supone 15-22 µF efectivos; con 16 V se conserva ~30 % más. | C11 y C58 ocupan más (0805). | Propuesto: aplicar en Altium |
| D-21 | **R7: 24.9 kΩ → 22.1 kΩ (C25961, 0603WAF2212T5E, ya en el diseño como R57)**. | El pin EN del MP1584 tiene abs. máx. 6 V («All other pins», p.2); con R6/R7 = 100 k/24.9 k a VIN_PROT 27.8 V da 5.54 V (margen 8 %); con 22.1 k da 5.03 V (+19 %). Además el UVLO propio sube de 7.52 V a 8.29 V (≥ Vout+3 V = 8 V). | UVLO de arranque del buck 6.99-9.12 V (con la tolerancia de EN 1.35-1.65 V); el eFuse ya impone 8.8-9.2 V. | Propuesto: aplicar en Altium |
| D-22 | **L1 SRP7050TA-220M se mantiene** aunque Isat 5.5 A < 1.2 × 4.7 A (límite de corriente del MP1584) = 5.64 A (-2.5 %). | En cortocircuito el pico es 4.7 A + 0.13 A (overshoot de 100 ns × 28 V / 22 µH) = 4.83 A (14 % bajo Isat); la carga real es 0.72 A con pico de 0.85 A. No hay alternativa de 22 µH, 7×7 mm y mayor Isat con stock en JLCPCB (FXL0630-220-M: Isat 3 A). | Ninguno práctico. Stock de L1: 545 unidades (C1332438) [VERIFICADO 2026-10-29]. | Aceptado, a confirmar por el estudiante |

| # | Desviación / recorte | Motivo | Impacto | Estado |
|---|---|---|---|---|
| D-23 | **Q2: 55 redes nombradas** con etiquetas sobre cables reales (hojas 01, 02, 05, 07-11): 128/128 redes con el nombre previsto. | Nombres automáticos (`NetJ4_2`…) ilegibles para ruteo, DRC y clases de red. | Ninguno funcional; ERC sin avisos nuevos. | Cerrado [VERIFICADO: F3_global.py tras recarga] |
| D-24 | **Q4: los NoERC no se reflejan en lo que lista el puente.** Prueba con una red (AIN0_DIV): sin cambio tras recompilar. Se retira el NoERC de prueba; los 34 avisos «no driving source» se justifican uno a uno en `Q4_erc.md` (símbolos pasivos: divisores, filtros RC, entradas del ADC). | Limitación de la API/ERC. | «0 errores» no se afirma sin el recuento del panel Messages. | [PENDIENTE: estudiante] |
| D-25 | **Q5:** D-11 (orden de pines OLED) y D-12 (polaridad BAT-HLD-001) siguen abiertos; geometría de BT1 verificada contra el plano de TE (±0.01 mm). Gerber finales bloqueados hasta confirmación escrita de ambos. P-08 redactada y con márgenes (OVP 26.45-27.70 V; rearme 24.5-25.4 V). | Riesgos que no se pueden corregir tras fabricar. | Ver `Q5_decisiones_fisicas.md`. | [PENDIENTE: estudiante] |

| # | Desviación / recorte | Motivo | Impacto | Estado |
|---|---|---|---|---|
| D-26 | **P5: se borraron las 7 reglas «Schematic Supply Nets»** que el ECO creó en NEXUS32.PcbDoc (tipo 41, sin valor de tensión); quedan 35 reglas. | No llevaban valor y el DRC las trataba como regla sin umbral; las reglas reales se crean en el bloque R2 con los límites de JLCPCB (consulta 2026-10-29). | Ninguno: no había reglas de supply válidas que perder. | Cerrado [VERIFICADO: pcb_get_design_rules] |
| D-27 | **P6: los 4 agujeros de montaje M3 pasan de 4 pads PTH libres (`MH1..MH4` del F4) a 4 componentes `MH1..MH4`** con símbolo `MOUNTING_HOLE_M3` (sin pines, círculo r = 100 mil) y huella `MH_M3`: pad Ø3.2 mm **no chapado** (`lib_set_pad_props`, plated = False), exclusión de cobre r = 3.5 mm (KeepOut), serigrafía r = 3.7 mm y patio r = 3.9 mm (Mechanical1). Colocados en 00_TOP_LEVEL (x 6000-9000, y 3500). | Un agujero M3 chapado queda conectado a cobre y a la rosca del tornillo; NPTH es lo correcto. Como componente entra al ECO sin romper la correspondencia esquema ↔ PCB (un footprint suelto aparecería como «extra» en `proj_compare_sch_pcb`). | 220 componentes, 128 redes, 658 pines (sin cambio de redes ni pines). En F7 hay que **excluir MH1-MH4 del BOM y del CPL** (igual que los TP, D-09). | Cerrado 2026-10-29 07:17 [VERIFICADO]: ECO del estudiante (4 altas + clase `00_TOP_LEVEL`; las 7 reglas «Supply Nets» se dejaron sin añadir), 4 PTH borrados, MH1-4 en (295, 295), (6004, 295), (295, 4429), (6004, 4429) mil con error 0; `proj_compare_sch_pcb` 220/220; 128 redes; 658/658 pines con red correcta; `Pads6` guardado: 690 pads, MH con byte de chapado = 0 (igual que las guías NPTH del RJ45). **Re-verificado el 2/11/2026 en el archivo guardado con `evidencia\F5_pads_chapado.py` [VERIFICADO]:** de 60 pads con agujero hay 52 chapados y 8 sin chapar, que son MH1-MH4 (126 mil), J8-S1 ×2 (24 mil) y J6-SH ×2 (128 mil) |

| # | Desviación / recorte | Motivo | Impacto | Estado |
|---|---|---|---|---|
| D-28 | **R2: reglas base más ajustadas que las de Altium y 10 clases de red** (detalle en `planificacion\evidencia\R2_clases_y_reglas.md`): Clearance 10 → 8 mil, Width 10/10/10 → 6/8/100 mil, HoleSize 1-100 → 12-200 mil, HoleToHole 10 → 18 mil, ComponentClearance horizontal 10 → 12 mil; reglas de ancho y separación por clase (HV 12 mil, contactos de relé 20 mil, pads de paso fino 5 mil). | Límites de JLCPCB (2026-10-29), cálculo R1 y separación real entre pads (J8 5.5 mil, U1/U10/U11/U14 7 mil). Con 100 mil de máximo en HoleSize los agujeros M3 (126 mil) habrían dado violación. | USB 12 mil y ETH 10 mil (enteros) en vez de 12.5 y 10.4: dentro de ±10 %. Sin clase propia: V3V3_RF y COIL1/2. | Reglas creadas y verificadas en el PcbDoc guardado. **Pendiente (GUI, estudiante, antes de rutear):** bajar al final las prioridades de `Clearance` y `Width` (la API deja las reglas nuevas en prioridad 2+ y las de All siguen en 1); además RoutingVias 12/24 mil, expansión de máscara 2 mil y sliver 4 mil (no editables por API) |
| D-29 | **Cobre a borde de placa 0.3 mm (JLCPCB)** sin regla de DRC: este Altium no tiene regla de distancia al contorno creable por API. | Limitación de la API. | Se cubre con un anillo de exclusión en KeepOutLayer a 12 mil dentro del contorno (R3/F5) y con `audit_find_pads_near_board_edge`. | Abierto (R3) |

| # | Desviación / recorte | Motivo | Impacto | Estado |
|---|---|---|---|---|
| D-30 | **R3: colocación por zonas con motor propio** (`R3_auto.py`, evidencia en `planificacion\evidencia\R3_colocacion.md`) en vez de `pcb_plan_placement`; zonas de la figura p.6 del enunciado (±3 mm). Los bloques que la figura no muestra (USB-UART, RTC/EEPROM con pila, OLED y botones) van donde propone 02 §11 / P-10 (USB-C en el borde izquierdo, RTC junto al ESP32, cabezal del OLED en el centro). **La referencia REF3033 (U5) y sus condensadores van junto al ADC**, no en la zona de potencia de su hoja. | `pcb_plan_placement` dejó la zona de potencia ilegal (solapes de patio) y no pega los condensadores al CI; V3V3_REF medía 127 mm con U5 en la zona de potencia. | Desacoplo a pines de CI: mediana 2.5 mm, máximo 6.3 mm (3 condensadores en el único pin 3V3 del ESP32); polaridad de diodos/LED en 4 orientaciones. | Colocada y medida; **pendiente de aprobación del estudiante (R4)** y de verificar el sentido de entrada de cable de las 6 bornas en 3D |

| # | Desviación / recorte | Motivo | Impacto | Estado |
|---|---|---|---|---|
| D-31 | **R3b: segunda pasada de colocación (sustituye a D-30 en lo medido)** con motor propio `R3b_auto.py`: separación 0.6 mm entre piezas, 1.0 mm de un punto de prueba a cualquier pieza y 2.0 mm entre TP, anillo libre de 2 mm alrededor de los CI, desacoplo asignado al CI de la hoja, condensadores con hueco de vía de 0.9×0.9 mm, filas por canal del ADC, **giro de 180° de J1, J2, J9 y J10** (la abertura del cable miraba al interior en la vista 3D del estudiante) y etiquetas de pin en la serigrafía. Calibrada con el DRC de Altium: la regla Component Clearance no estaba en el DRC por lotes (casilla Batch) y daba 10 violaciones en la v3, todas con un TP (patio de 0.25 mm de la huella). | La v3 apelotonaba piezas a 0.3-0.5 mm, dejaba los CI sin salida libre y `route_plan` completaba 109 de 120 redes. | v3 → R3b: pares < 0.5 mm 48 → 0; Component Clearance 10 → **0**; `route_plan` 109 → 117 de 120 (una pasada) y **120 de 120** (esfuerzo normal, en memoria); congestión máxima 24.4 → 19.6 %; desacoplo mediano 2.84 → 2.03 mm; ESD de USB a 2.5 mm (v3: 4.9). **No cumple del todo:** 8 ventanas de 10×10 mm siguen > 45 % sin contar las piezas grandes (v3: 10), la salida libre de U1, U2, U11 y U15 no mejora, y 8 condensadores voluminosos quedan a 3.3-5.8 mm de su CI. | Aplicada en la placa guardada; **R3b rechazada después por el estudiante** (piezas en grumos y zonas grandes sin usar) y sustituida por la propuesta R3c (D-33). Detalle en `planificacion\evidencia\R3b_colocacion.md` |

| # | Desviación / recorte | Motivo | Impacto | Estado |
|---|---|---|---|---|
| D-32 | **R4b: iteración acotada tras R4 aprobada con condiciones (2026-10-29).** Solo se movieron **C25** (a 2.31 mm del pin 8 de U8; antes 5.65 mm; meta ≤ 2.5) y **TP9** (de (101.0, 61.0), dentro del volumen del OLED, a (104.0, 55.0), 1.27 mm fuera del volumen). **Excepciones:** **C4** (4.82 mm de U2.7) y **C10** (5.07 mm de U4.3) NO alcanzan el ≤ 3.5 mm pedido; **J3** (cabezal del módulo OLED, 8.51 mm de alto) y **TP16** solapan 1.2-1.3 mm el borde izquierdo del volumen del OLED. | Búsqueda exhaustiva (±6 mm, rejilla de 0.25 mm, 4 giros): no hay ninguna posición a ≤ 4.1 mm de U2.7 ni de U4.3 sin mover piezas que no estaban en la lista de R4b (U1/C5/C6/L1 en U2; L2/C12/U3/L1 en U4); moviendo solo C4 y C10 la mejora es < 0.5 mm y no se aplicó. J3 es el ancla del OLED (cabezal de conexión del módulo, D-11 [SUPUESTO]); TP16 no estaba en la lista. | Medido sobre la placa guardada: Component Clearance **0** (DRC solo de esa regla), `route_plan` normal 120/120, 220/220 componentes, 128 redes, 658/658 pines, 0 piezas fuera del contorno, 0 solapes de cuerpo, reglas 48/48, lazos de U2 sin cambio (SW→L1 2.65 mm, SW→D4 2.51 mm). Efecto colateral: salida recta libre de U8 de 4 a 2 pines. Tiempo 73 min frente a los 45 acotados (≈ 40 min de espera de cargas lentas de Altium). | Aplicada y guardada (respaldos `R4b-inicio`, checkpoint `20261029-184534-163509`, y `R4b-aplicada`). **[PENDIENTE: estudiante]** elegir para C4/C10: (A, recomendada) aceptar la excepción y compensar en F5 con pistas anchas y cortas, (B) mover C5 y C6, o (C) mover C12 y C16; y decidir sobre TP16. Detalle en `planificacion\evidencia\R3b_colocacion.md` §7 |

| # | Desviación / recorte | Motivo | Impacto | Estado |
|---|---|---|---|---|
| D-33 | **R3c: redistribución de componentes (propuesta OFFLINE, 2026-10-29).** El estudiante rechazó R3b. Se rehace con un optimizador de recocido simulado (`R3c_sa.py`) que minimiza longitud de cable + penalización de densidad (> 35 %) y de vacío (< 12 %) con macros rígidos (CI + soporte), canales ≥ 4.3 mm entre macros, separación entre pasivos 1.5 mm, TP a 2 mm de cualquier pieza y 3 mm entre TP, polaridad de diodos/LED por familia y las zonas de la figura p.6 (±3 mm). Anclas sin cambio: BT1, J1-J10, K1, K2, U6, U12, U13, MH1-4. **Ampliación documentada:** la zona ADC sube a y 94 (J4 llega a y 96; las filas AIN se alinean con sus pines). | La colocación R3b pasó DRC y `route_plan` pero dejó grumos (9 ventanas de 10×10 mm > 40 % sin anclas) y 46 % de las ventanas en zona con < 10 % de ocupación. | v3 → R3b → **R3c** (medidas offline, mismas definiciones): ventanas en zona < 10 %: 49.4 → 46.2 → **24.4 %**; ventanas > 40 % sin anclas: 12 → 9 → **1** (lazo caliente de U2); pasivos a < 1.5 mm: 69 → 46 → **0**; TP a < 2 mm de una pieza: 21 → 22 → **0**; desacoplo máximo 100 nF 21.4 → 2.73 → **2.17 mm**, mediana 2.84 → 2.03 → **1.86 mm**, bulk máximo 15.6 → 5.8 → **3.92 mm**; `route_plan` normal 116 → 120 → **120/120** (120 vías, longitud −2.4 % frente a R3b), fast 113 → 117 → **118/120**; polaridad unificada. **No cumple:** (a) ventanas vacías ≤ 20 %: cota aritmética 21.2 % (ETH solo tiene 70 mm² de piezas movibles para 25 ventanas libres y LORA 13 mm² para 12; la placa de la figura tiene 26.5 % de ocupación media); (b) congestión máxima ≤ 15 %: 20.0 % en los pines del ESP32 (ancla; R3b 19.6 %, v3 24.4 %); (c) pin VBUS de D7 a 5.37 mm de J8 (R3b 2.64; D+/D− a 2.74/2.98 mm; el giro que lo acerca hace fallar `USB_DN` en `route_plan`). | **Aprobado por el estudiante (plan, cota de ventanas vacías 24.4 % y zona ADC hasta y = 94) y APLICADO el 2026-10-30; [PENDIENTE: estudiante] aprobación escrita final (R4) antes de F5.** 113 de 200 piezas se movieron más de 5 mm (mediana 5.8 mm); ver D-34 y `R3c_aplicacion.md`. Detalle en `planificacion\evidencia\R3c_plan.md` e imagen `F3_vistas\R3c_plan_antes_despues.png` |

| # | Desviación / recorte | Motivo | Impacto | Estado |
|---|---|---|---|---|
| D-34 | **R3c aplicada (2026-10-30): una pieza fuera del plan y puntos para F5.** (a) **C7** (bootstrap de U2) se movió de (41.00, 71.25) a (36.90, 71.00), giro 0, para eliminar la única violación del DRC de Component Clearance (C7 a 0.09 mm de U2 y de L1). (b) Se anotan para reevaluar en F5 con el ruteo real: **D7 (USBLC6) pin VBUS a 5.37 mm de J8**, **cristales Y1 (X1_N 5.02 / X2_N 3.37 mm) e Y2 (OSC1_N 5.62 / OSC2_N 5.56 mm)** y la pista de bootstrap de C7 (SW5_N de 5.84 a 9.89 mm de HPWL). (c) El DRC colgó dos veces (el diálogo `Design Rule Checker` quedó en su pantalla de configuración); se cerró una vez con WM_CLOSE (apareció la regla duplicada `SolderMaskExpansion_1`, origen no confirmado, que se borró tras comprobar que era un duplicado exacto) y la segunda se pulsó «Run Design Rule Check...» por UI Automation. | La propuesta dejaba a C7 encajado en el hueco de 1.12 mm entre U2 y L1; la medida offline usa cajas de pads + cuerpo 3D y no el patio de la huella. | Sobre la placa guardada: DRC Component Clearance **0**, 220/220, 0 fuera del contorno, 128 redes, 658/658 pines, 0 con red distinta, reglas **48/48** (sin diferencias de `enabled`), `route_plan` normal **120/120** (124 vías, longitud −2.2 % frente a R3b) y fast 118/120, ventanas vacías en zona 24.4 %, > 40 % sin anclas 1 (lazo caliente), pasivos a < 1.5 mm 2 (C7-R11 0.55 mm, C7-R10 0.72 mm: excepción del lazo caliente), TP ≥ 2.1 / 3.25 mm, desacoplo máx. 100 nF 2.17 mm, mediana 1.87 mm, bulk 3.92 mm, lazos 2.93 / 2.15 / 1.68 mm, RUDY máx. 20.0 %. | Aplicada y guardada; respaldos `_respaldos\NEXUS32_2026-10-29_F3-R3c-inicio` y `NEXUS32_2026-10-30_F3-R3c-aplicada3` (definitivo; `-aplicada` contiene la violación de C7 y `-aplicada2` se hizo durante la recuperación del DRC). **R4 aprobada por escrito por el estudiante el 2026-10-30: colocación CONGELADA** (ninguna pieza se mueve ni gira sin propuesta con evidencia y OK escrito); **[PENDIENTE]** reevaluar D7/VBUS, Y1/Y2 y la pista de bootstrap de C7 con ruteo real en F5. Detalle en `planificacion\evidencia\R3c_aplicacion.md` |

## F5 — Ruteo (2026-10-30)

| # | Desviación / recorte | Motivo | Impacto | Estado |
|---|---|---|---|---|
| D-35 | **F5.0: la regla `DiffPairsRouting` (existente, alcance All) exige ancho 15/15/15 mil y hueco 10/10/10 mil**, lo que contradice `W_USB_DIFF` (10/12/14) y `W_ETH_DIFF` (8/10/12) de R2: con 15 mil el par daría 78.6 Ω (calculadora, h = 8 mil) en vez de 90 Ω (USB) o 100 Ω (Ethernet); un par a 12 o 10 mil violaría `DiffPairsRouting` en cuanto se marque «Batch» (acción GUI (c)) y uno a 15 mil violaría `W_USB_DIFF`/`W_ETH_DIFF`. R2 solo había comprobado el hueco. | Hallazgo de la lectura de reglas del 2026-10-30 (F5.0, solo lectura). La API no puede corregirlo: `pcb_set_rule_properties` no edita reglas de pares diferenciales y `pcb_create_design_rule` no fija el ancho de un par ni la prioridad. | **Propuesta, NO aplicada:** el estudiante edita en la GUI `DiffPairsRouting` a ancho mín 8 / pref 12 / máx 14 mil (hueco 10/10/10 sin cambios), de modo que USB (12 mil) y Ethernet (10 mil) quepan y los límites por clase `W_*_DIFF` sigan vigentes; no relaja ninguna otra regla. | **APROBADO por el estudiante (2026-10-30, «CONFIRMO GUI» punto d); [PENDIENTE] la edición NO está aplicada en la placa: a las 12:28 `DiffPairsRouting` sigue en ancho 15/15/15 (el archivo no se guardó desde las 02:13:42; ver `F5_verificacion.md`)**; verificación con `pcb_get_rule_properties` cuando el estudiante repita las acciones GUI. Detalle en `planificacion\evidencia\F5_preparacion.md` §7 |
| D-36 | **F5.1: `C_FINEPITCH_PADS` solo cubría pad con pad y en 5 de 51 pads de J8/U1/U10/U11/U14 no cabía ninguna pista de su clase** (U1.2 VIN_F y U1.15 VIN_PROT: máx. 10 mil frente a un mínimo de 12; U10.4 y U11.4 V5V0: 14 frente a 15; U14.6 V3V3: 10 frente a 12), porque la regla de la clase (12 / 10 / 8 mil) se mide contra el pad vecino, a 7–8 mil; además J8.B7 y U14.5 (USB_DN) tendrían que estrecharse a 10 mil. | Orden de las reglas `C_*` revisado a petición del estudiante («CONFIRMO GUI», punto 2) con la geometría de la placa guardada R3c (`F5_paso_fino.py`). | **APROBADA por el estudiante (2026-10-30, segundo «CONFIRMO GUI») y APLICADA por API a las 15:3x** con `pcb_set_rule_properties(name='C_FINEPITCH_PADS', scope2='All')`: alcance 2 de «pads de esos 5 componentes» a `All`; hueco 5 mil sin tocar. **Texto original (para revertir; copia en `F5_D36_original.json`):** scope1 = scope2 = `(InComponent('J8') Or InComponent('U1') Or InComponent('U10') Or InComponent('U11') Or InComponent('U14')) And IsPad`, gap 5 mil, prioridad 2, comentario «pads de paso fino: J8 5.5 mil, U1/U10/U11/U14 7 mil entre pads (JLC min 3.5 mil)». **Condición del estudiante:** 5 mil solo en el abanico del pad; fuera de ahí ≥ 8 mil, y ≥ 12 mil en VIN_F y VIN_PROT donde quepa (se cumple en el diseño del ruteo y se comprueba con un chequeo geométrico propio; el DRC no la distingue). **Efecto lateral no pedido:** reescribir la regla por API la subió a la prioridad 1 de su tipo (`C_FINEPITCH_PADS` 2→1, `Clearance` 1→2; las demás sin cambio). | Verificado con `pcb_get_rule_properties` (`Gap=5mil (…And IsPad),(All)`, habilitada) y `F5_verificar_reglas.py`. **Guardado en el archivo el 2026-10-31 01:22:45** (verificado leyendo el archivo; antes solo en memoria, con el archivo en 02:13:42); la nota antigua decía que se guardará con el File ▸ Save All del estudiante. |
| D-37 | **F5.2: acción GUI (a) hecha por API** (prioridades: `Clearance` y `Width` generales al final), autorizada por el estudiante el 2026-10-30. Se aprovechó que reescribir una regla por API la sube a la prioridad 1 de su tipo: se reescribieron con valores y alcances IDÉNTICOS, en este orden, `C_PWR_HV`, `C_RELAY_CONTACTS`, `C_ANALOG`, `C_FINEPITCH_PADS` y después, en orden inverso al previo, `W_PWR_HV`, `W_PWR_5V0`, `W_PWR_3V3`, `W_V3V3_RF`, `W_SW_NODES`, `W_RELAY_CONTACTS`, `W_USB_DIFF`, `W_ETH_DIFF`, `W_RF_50R`. | La API no escribe prioridades; el estudiante pidió desbloquear las reglas sin esperar a la GUI (él hará solo vía 12/24, máscara 2, sliver 4, `DiffPairsRouting` 8/12/14, las casillas Batch y cerrar `DISPOSABLE_TEST`). | **Estado anterior (para revertir):** tipo Clearance: `C_FINEPITCH_PADS` 1, `Clearance` 2, `C_ANALOG` 3, `C_RELAY_CONTACTS` 4, `C_PWR_HV` 5; tipo Width: `Width` 1, `W_RF_50R` 2, `W_ETH_DIFF` 3, `W_USB_DIFF` 4, `W_RELAY_CONTACTS` 5, `W_SW_NODES` 6, `W_V3V3_RF` 7, `W_PWR_3V3` 8, `W_PWR_5V0` 9, `W_PWR_HV` 10 (copia en `F5_reglas_estado_antes_D37.json`; revertir = `python F5_prioridades.py revertir`, que reescribe `Clearance`, `C_FINEPITCH_PADS` y `Width` con los valores previos). **Estado nuevo:** `C_FINEPITCH_PADS` 1, `C_ANALOG` 2, `C_RELAY_CONTACTS` 3, `C_PWR_HV` 4, `Clearance` 5; `W_RF_50R` 1, `W_ETH_DIFF` 2, `W_USB_DIFF` 3, `W_RELAY_CONTACTS` 4, `W_SW_NODES` 5, `W_V3V3_RF` 6, `W_PWR_3V3` 7, `W_PWR_5V0` 8, `W_PWR_HV` 9, `Width` 10. | Verificado a las 16:05: 48/48 habilitadas; ni un descriptor, alcance, comentario, tipo ni estado cambió (solo prioridades; `F5_prioridades.py`, `F5_D37_registro.json`, `F5_reglas_estado_post_D37.json`). **Guardado en el archivo el 2026-10-31 01:22:45** (verificado leyendo `NEXUS32.PcbDoc` a las 14:29: `C_FINEPITCH_PADS` 5 mil, prioridades de D-37 y 48/48 habilitadas; `app_save_all` reescribió además `DISPOSABLE_TEST`, ver D-41; antes estaba solo en memoria y la condición era que el estudiante confirmara que `DISPOSABLE_TEST` está cerrado). |
| D-38 | **F5.3/F5.4: `L2_GND` = red GND y `L3_PWR` = plano completo de V3V3, una sola red y sin particiones**, en lugar de «L3 alimentación (planos 5V0/3V3 por zonas)» de **DEC-001** (enmienda anotada en `03_DECISIONES.md`). Cumple REQ-073 (plano de referencia continuo: L2 sólido bajo Top y L3 sin particiones bajo Bottom). Hoy ambos planos tienen red «(No Net)» en el archivo guardado. | V5V0 (29 pines en 5 grupos) y V3V3 (41 pines) se reparten por toda la placa. Con `route_plan` offline: V3V3 por pistas no cabe (fallan V3V3, SCK y el par USB); con L3 = V3V3, V5V0 por pistas cabe a 15 mil (372 mm). El plano único evita particiones que cruzar en Bottom y es una sola acción de GUI. | V5V0, VIN24, VBAT, VIN_OR, VIN_F, VIN_PROT y VBUS_USB pasan a ruteo por pistas (V5V0: tronco 20 mil, ramas ≥ 15 mil, por Bottom si el tronco no cupiera; VIN: 20 mil preferido, 12 mil junto a U1); V3V3 con ≥ 2 vías donde pasen > 1 A; ≈ 300–370 vías 12/24 mil; recortes de L2/L3 bajo la antena del ESP32 y los magnéticos del RJ45 en el cierre de F5. **Condiciones del estudiante:** (a) reglas de plano revisadas: `PlaneClearance` 20 mil y `PlaneConnect` (relieve 4 × 10 mil) existen y cumplen JLCPCB (vía a cobre interno 0.2 mm, pad PTH a cobre interno 0.3 mm), sin cambios; (b) campo de vías planificado para no fragmentar L2/L3 (política y comprobador `F5_planos.py` en `F5_planos.md`), continuidad a comprobar antes del DRC final; (c) anchos y vías de potencia anotados. | **APROBADO por el estudiante (2026-10-30).** **[PENDIENTE: GUI del estudiante]** asignar la red GND a `L2_GND` y V3V3 a `L3_PWR` (Layer Stack Manager); verificación: lectura del archivo guardado (`F5_reglas_archivo.py`: `PLANE1NETNAME`/`PLANE2NETNAME`) y DRC, porque la API no expone la red de los planos. Detalle en `planificacion\evidencia\F5_planos.md` |
| D-40 | **F5 piloto 2: las pistas del par USB (USB_DP/USB_DN) van a 10 mil, no a 12 mil, en el abanico del conector J8 y en el tramo D7 → U14** (hueco 10 mil entre ellas). | J8 y U14.4/U14.5 tienen los pads a paso de 0,5 mm: con pistas de 12 mil quedan 7,7 mil entre pistas vecinas (< 8 mil de `Clearance`). 10 mil es el mínimo de `W_USB_DIFF` (10/12/14), así que cumple la regla; el ancho preferido solo guía al enrutador. | Impedancia diferencial algo mayor que los 90 Ω del cálculo (≈ 97 Ω a 10 mil; USB 12 Mbps con ≈ 17 mm de longitud: sin consecuencia práctica). Si prefieres 12 mil donde quepa (fuera de los pasos de 0,5 mm), se ensancha el tramo central después. | **APROBADO por el estudiante (2026-10-31 14:48, «D-40 conforme»):** 10 mil solo en el abanico J8/D7 y en D7 → U14; 12 mil en el resto. Detalle en `planificacion\evidencia\F5_pilotos.md` §5.2 |
| D-41 | **F5: guardar con `app_save_all` reescribe también `DISPOSABLE_TEST.PcbDoc` y `.PcbLib`** (solo cambia la fecha; no se abrieron). `proj_save` devuelve «success» pero no escribe `NEXUS32.PcbDoc`. | No hay otra vía de guardado por API que escriba NEXUS32 sin tocar DISPOSABLE_TEST; ocurrió a las 01:22:45 (31/10), contra la petición del estudiante de no tocarlo. | Ningún dato del proyecto NEXUS32 afectado; los scripts del puente (`.pas`, `.PrjScr`) no se modificaron. | **AVISADO (2026-10-31).** Se deja de reescribir si el estudiante cierra DISPOSABLE_TEST en Altium (yo no cierro proyectos). |
| D-42 | **F5: zona de antena del ESP32-WROOM-32E acotada con la hoja de datos y la guía de Espressif; el keep-out de cobre pasa de 22 × 8 mm (x 44–66 × y 112–120) a la zona de la hoja (18 × 6,19 mm) más la franja de 15 mm de la guía a la izquierda del módulo (x 31–66 × y 113,3–120).** | Hoja de datos v2.1 Fig. 3 (p. 10), Fig. 10 (p. 40), Fig. 13 (p. 43): área de antena 18 × 6,19 mm. ESP-HDG, figura «Keepout Zone for ESP32 Module's Antenna (feed on the right)»: ≥ 15 mm junto al extremo libre, ≤ 2 mm junto al feed, ≤ 1 mm de placa sobre la antena (cotas leídas en la imagen, no vienen en el texto de la página). El feed del módulo está a la derecha (Fig. 10), así que los 15 mm van a la izquierda. R3b/R3c solo habían reservado x 44–66 (2 mm de margen) con [SUPUESTO: dimensiones no verificadas]. | **0 pistas/vías de ninguna capa dentro** (163 colocadas + 65 planificadas): más cercano 5,01 mm de la zona de la hoja y 3,23 mm de la franja; RXD0 y TXD0_CHIP por Bottom quedan a ≥ 5 mm (aceptadas). **SW1 entra 0,76 mm en la franja** (no se mueve: no es R/C). Propuestas: ampliar el recorte de L2/L3 a x 31–66 × y 113,3–120 en el lote 13; la guía recomienda además una muesca en el contorno a ambos lados y debajo de la antena (tu contorno es un rectángulo completo; no lo toco). | **PROPUESTO (2026-10-31 15:10); pendiente: SW1, recorte de planos y muesca (decisiones del estudiante).** Detalle en `planificacion\evidencia\F5_verificaciones_v3.md` §1 |
| D-43 | **F5: ninguna vía dentro de un pad SMD** (regla de diseño provisional); las 2 vías de GND colocadas en el pad térmico de U2 (U2.9) se sustituyen por 2 vías exteriores unidas por pistas Top de 20 mil. | Las páginas de JLCPCB (capacidades y guía de vía en pad, leídas el 2026-10-31) describen la vía en pad como relleno de resina + tapa chapada, «default for 6-layer and above», avisan del riesgo de wicking/huecos de soldadura («Solder wicking: During reflow, molten solder may flow through the via…») y **no dicen si se admite, cuánto cuesta ni qué plazo tiene una vía abierta o rellena en una placa de 4 capas**. [PENDIENTE: JLCPCB]. | Nuevas vías de U2.9 en (1576, 3012) y (1512, 2832) mil, pistas de 2,34 y 2,62 mm, 0 conflictos, borde de vía a ≥ 8 mil de todo pad. Algo más de resistencia térmica del pad (el MP2315 disipa < 1 W) [SUPUESTO aceptable]. **Casos sin hueco fuera del pad, pendientes de decisión:** pad térmico de U14 (U14.29, tierra única del CP2102N) y los 9 pads de GND bajo el módulo U6 (F5_planos §3: 4 vías de plano dentro del bloque): opciones = vías en el pad si JLCPCB lo admite en 4 capas (consultar al soporte), o vías de 0,25/0,15 mm en los huecos de 0,5 mm. | **APLICADO el 2026-11-01 00:14 (plazo de 90 min de la v3 vencido sin respuesta; DRC 0).** Detalle en `planificacion\evidencia\F5_verificaciones_v3.md` §2 |
| D-44 | **F5: A3 con tus condiciones: C4 NO se mueve (lote 1b-S1), D7 y C57 quedan pendientes de decisión.** | C4 está a 3,92 mm de U2.7 (límite R3c y tuyo: 4 mm) y está justo encima: +0,6 mm → 4,52; +0,8 → 4,72; +1,0 → 4,92. D7: el mínimo que cabe es +0,40 mm (+0,45 con margen) y lleva el ESD de 2,99 a 3,36–3,46 mm de J8 (límite R3c 3,0). C57 necesita +1,2 mm (a 2,47 mm de su pin de U14; límite 2,5). | Lote 1b-S1 sin mover nada: tierra de U2.5 (vía (1400, 3004) mil), tierra de C4.2 (vía (1388, 3146)) y VIN_PROT de C4.1 con 6,02 mm y **2 vías** (1408, 3092) y (1342, 3026) por Bottom; 0 conflictos `drc` y `dis`. La esquina USB-C de J8 (0 conflictos con D7 +0,40…0,5 y C57 +1,2) no se coloca sin tu sí a D7. | **APLICADO el 2026-11-01 00:14 (lote 1b-S1, sin mover C4; DRC 0); D7/C57 siguen esperando la decisión del estudiante.** Detalle en `planificacion\evidencia\F5_verificaciones_v3.md` §3 |
| D-45 | **F5: corregido el modelo de pads del diseno offline (extension intercambiada en 132 de 690 pads) y el comprobador de HoleToHole; se regeneran todos los lotes.** | Altium da `x_size`/`y_size` en el marco LOCAL del pad: con rotacion absoluta 90/270 la extension en el tablero va intercambiada. El modelo heredado de la cache R3c (`R3c_cache_final2.pkl`) la tenia mal en 132 pads (pasivos R/C a 90/270 grados, D3, D8, D9, Y2) y SW3 desplazado 20 mil. Lo destapo el DRC del lote 3 (V5V0) del 2026-11-01 00:22: 1 violacion `Clearance` (pista V5V0 frente a D8.1, 4,5 mil < 8); el comprobador exacto usaba el mismo modelo y no la veia. Ademas el router ignoraba los taladros de la propia red (14 violaciones `HoleToHoleClearance` en el primer intento del lote 13: vias duplicadas o a 10 mil entre si) y puse 8 mil en tramos de V3V3 (`W_PWR_3V3` exige >= 12; 4 violaciones). | `F5_geom.cargar_pads` lee ahora la lectura real de Altium (`F5_geometria_P1P2.json`); contraste: el registro completo del cobre colocado da exactamente la violacion de Altium y nada mas; el lote 13 defectuoso da exactamente sus 14 + 4. El cobre piloto (lotes 1a, P2 senales, 1b-S1, vias de U2, RF/cristales) ya habia pasado el DRC de Altium con 0 y no cambia. Retirados de Altium el lote 3 (117 objetos) y el primer lote 13 (531 objetos) y regenerados todos con el modelo y los comprobadores corregidos. | **CORREGIDO (2026-11-01).** Detalle en `planificacion\evidencia\LOG_M2.md` (2026-11-01) |
| D-46 | **F5: la conexión SQW → U6.4 (pin SENSOR_VP del ESP32; salida de onda cuadrada del RTC, el DS1307 no tiene alarma) queda SIN CONECTAR.** | El pad GND de C21 (x 44,03–44,97 / y 107,77–108,58) está a 0,5 mm delante del pin 4 y el único canal hacia la izquierda (32 mil entre los pads de C21) lo usa EN en U6.3. Probado con rejilla de 2 mil, 6 mil de ancho, pasillos reservados y rip-up: sin solución sin mover piezas. **v5 (2026-11-01 noche, 45 min):** con permiso para mover C21/C20/C22 (desacoplo de U6.2 ≤ 2,5 mm) el prefiltro geométrico (`F5_sqw_prefiltro.py`, `F5_sqw_prefiltro2.py`: cajas a ≥ 0,3 mm, pads, zonas de antena, pasillos rectos de EN/SQW/DIO1) solo encuentra salida moviendo C21 ≈ +0,20 mm en x y +2,21 mm en y y C22 ≈ −0,79 mm en x (72 combinaciones; desacoplo de C21 a U6.2 1,98 mm; con C20 no hay ninguna); con esa variante SQW sí ruta (29 mm, 2 vías) pero el rip-up de las 24 redes de señal de U6 (535 objetos) no cierra en 3 pasadas (pasada 1: 7 pads sin ruta; pasada 2: 5, con SQW ya ruteada pero sin DIO0, RST_LORA, CS_ENC y RLY2; pasada 3: otros 5; y el pad GND de C21 movido sin vía) y exigiría varias rondas de reparación sobre una placa ya con DRC 0. | Se aplica la decisión del estudiante del v5 (§1a): «si no sale lo dejas sin conectar y documentado». Consecuencia: el RTC sigue funcionando (la hora se lee por I²C); solo se pierde la señal de 1 Hz hacia GPIO36, que el firmware no necesita. Si más adelante sobra tiempo, el diseño de la variante está en `F5_ic_mover.py` (`python F5_ic_mover.py U6 MOVER=C21:0.2032:2.2098,C22:-0.7874:0 PRIMERO=SQW,EN`); no se ha aplicado nada. | **CERRADO como «sin conectar» (2026-11-01 v5).** Ninguna pieza movida. Detalle en `planificacion\evidencia\F5_v5_noche.md` §5. **Revisado en A3 (2026-11-05, Fase 1) y CONFIRMADO «sin conectar» por decisión del estudiante (por delegación).** Medido con la geometría real de la copia (690 pads, 1736 pistas, 369 vías) y el motor exacto de holguras `F5_geom`: (A) con el cobre y las piezas tal cual: sin ruta; (B) quitando EN (7 pads, 26,6 mm) y DIO1 (87 mm) y rutando SQW primero: sin ruta, la vía de 24 mil no cabe junto a U6.4 (U6.3 y U6.5 a 15 mil de borde, C21.2 con su pista GND de 20 mil a 21 mil); (C) única ruta legal: vía de 24/12 mil DENTRO del pad U6.4 en (1806, 4261) mil y 6 pistas de 8 mil en Bottom (21,9 mm, 0 violaciones DRC exactas) hasta la vía SQW (2648, 4220). **Alternativa C descartada por D-43** (ninguna vía dentro de un pad SMD; JLCPCB no documenta vía en pad abierta o rellena para 4 capas y avisa de que la soldadura puede escurrirse por el agujero) y por el riesgo sin medir de la regla `SolderMaskExpansion_Vias` sobre una vía en pad. Mover C21/C22 sigue descartado (colocación congelada, el re-ruteo en cascada de U6 no cierra). Si el estudiante escribe «OK EXCEPCIÓN D-43 SQW», se aplica C con checkpoint y la puerta completa. Detalle: `A3_TRABAJO\FASE1_SQW.md` |
| D-47 | **F5 v5: orientación de la salida de cable de J4/J5 (bornes DB127S 5P) y de la boca del RJ45 J6.** J6 (HR911105A, giro 180°, caja y 0,3–21,9 mm, borde de placa y = 0): la boca mira al borde inferior (hacia fuera). J4/J5 (giro 90°, caja x 146,0–158,0 mm, borde x = 160): el cable puede entrar por el lado exterior (x = 158). | J6: hoja HR911105A p. 2 (vista inferior: pines de señal 1–8 en un extremo y los pines de los LED y los postes del blindaje en el otro, junto a la boca; vista frontal: los LED están en la boca). En la huella los pads de los LED (J6.9–12) están en y = 6,6 mm, los postes del blindaje (SH) en y = 11,5–14,6 mm y los pines de señal en y = 17,8–20,4 mm: la boca está en el extremo de los LED, que es el del borde y = 0. Modelo 3D de J6 (ajustado a los pads): la cara del lado de los pines de señal es la trasera y la opuesta es la frontal. J4/J5: el modelo STEP de DB127S-5.08-5P tiene canales de cable de ≈ 5,7 mm de profundidad desde las DOS caras largas (caras de fondo a y ≈ 50,5–51,1 mm del modelo desde ambos lados) y las vistas izquierda y derecha de la hoja Dorabo son simétricas: se puede meter el cable por cualquiera de los dos lados. Contraste: el modelo KF128-3P (J1, J2, J9, J10, orientados por el estudiante en D-31) solo tiene aberturas de cable en una cara, así que el método distingue ambos casos. | Ninguna salida obliga a meter el cable desde el interior: J6 mira al borde y J4/J5 admiten entrada por el lado exterior. Sin cambio de giro ni de posición. | **[VERIFICADO con hoja de datos y huella para J6; [SUPUESTO] razonable para J4/J5** (el modelo 3D es de EasyEDA y la hoja no dice «doble entrada» con esas palabras). Si quieres certeza total, una captura 3D lateral de J4 con la abertura del cable hacia x = 160 lo cierra. **v5.1 punto 6: J4/J5 sigue como [SUPUESTO] hasta que llegue esa captura; no se cambia nada por ello.** **Captura recibida el 2026-11-01 (vista 3D cenital con perspectiva, no lateral):** no muestra la cara donde está la abertura del cable, así que J4/J5 **sigue [SUPUESTO]** (decisión del v5.1 punto 6). Lo que sí se ve: en J4/J5 los tornillos (óvalos) quedan del lado del interior y las ventanas cuadradas hacia el borde exterior; en J1/J2 es al revés (tornillos hacia el borde), así que la disposición está espejada respecto al borde, sin que eso fije por sí solo de qué lado entra el cable. J6 se ve saliendo por el borde inferior, coherente con la boca hacia fuera. El aparente saliente de J1/J2/J9/J10 por el borde izquierdo y de J6 por el inferior es perspectiva (la vista está centrada hacia x ≈ 128 mm, y ≈ 102 mm): los cuerpos están 0,3–0,5 mm dentro del contorno según la huella. Detalle en `planificacion\evidencia\F5_v5_noche.md` §3 |
| D-48 | **F5 v5: pares Ethernet (TPOUT_P/N y TPIN_P/N): solo Top, sin vías; diferencia P-N ≤ 2 mm solo conseguida en TPOUT; TPIN queda a 12,1 mm y sin acoplar.** | Acoplar los pares (pista N pegada a la P a 20 mil entre ejes) no es posible con el orden de pads de la placa: en U12, D6, R47–R50 y J6 el par cambia de orden respecto al sentido de avance (la pista N queda encerrada por la P o tendría que cruzarla). Probé 24 combinaciones de orden de visita (una pista guía con mapa de 30 mil y la otra atraída por un sesgo de coste): ninguna acopla (0 mm acoplados) y las que rutean dan P-N de 17 a 63 mm. Con el cobre real: TPOUT_P 45,8 mm y TPOUT_N 56,9 mm (P-N 11,1 mm); TPIN_P 20,6 mm y TPIN_N 32,7 mm (P-N 12,1 mm). Para TPOUT se añade un meandro cuadrado a TPOUT_P (2 pliegues de 98 mil en el tramo vertical x = 114,7 mm, y 12,2–19,4 mm; +9,96 mm → 55,8 mm; P-N **1,2 mm**; comprobación propia drc y dis: 0 conflictos; `F5_meandro.py TPOUT_P 10.0`, `F5_mea_TPOUT_P_*.json`). Para TPIN no cabe ningún meandro (ni de 4 mm) en las 5 rectas de TPIN_P (la mayor mide 4,7 mm y está rodeada de cobre) y TPIN_N no se puede acortar (mínimo 32,7 mm con TPIN_P puesta; 26,4 mm solo si TPIN_P no estuviera). | 10BASE-T (el ENC28J60 solo llega a 10 Mb/s): 12,1 mm de diferencia son ≈ 72 ps (≈ 6 ps/mm en microstrip) frente a 100 ns por bit, el 0,07 %: sin efecto práctico. Los pares no van acoplados (hueco variable). Si se activa «Batch» en `DiffPairsRouting` con la placa tal cual, Altium puede marcar longitud sin acoplar. | **ACEPTADO por el estudiante (2026-11-01, v5.1 punto 1): opción (a), sin mover D6, R49 ni R50. CUMPLIMIENTO PARCIAL de REQ-074** (ruteo diferencial donde corresponda, USB y Ethernet): TPOUT acoplado en longitud con el meandro (P-N 1,2 mm; pendiente de colocar tras «GUI LISTA»); TPIN sin acoplar (P-N 12,1 mm; unos 70–80 ps frente a 100 ns por bit en 10BASE-T) por el orden de pads de U12, D6, las resistencias y J6. El par USB va en Top salvo 3 vías de USB_DN en J8 (D-40, F5_pilotos.md §5). Detalle en `planificacion\evidencia\F5_v5_noche.md` §4 y `F5_v5_1.md` **[Meandro de TPOUT_P APLICADO el 2/11 18:26 y guardado: 1 pista borrada y 10 colocadas; TPOUT_P 55,77 mm y TPOUT_N 56,93 mm (1,16 mm de diferencia). Los pares Ethernet siguen contando como sin acoplar en DiffPairsRouting (TPOUT 2241 mil, TPIN 1289 mil), excepción aprobada en D-52.]** |
| D-49 | **F5 v5: pad térmico de U6 = 9 pads de 0,889 mm (paso 1,397 mm, hueco 0,508 mm) + relleno de GND en Top sobre el bloque y 2 vías en los cruces de huecos.** | El estudiante pidió «una región de GND en Top y vías fuera» de los pads. El land pattern de Espressif (Fig. 13 de la hoja del ESP32-WROOM-32E) marca «Via for thermal pad» en los huecos entre los 9 pads. Los cruces de huecos (52,793 / 54,191 mm × 103,606 / 105,017 mm) dejan la vía a 1,4–2,2 mil del cobre de los pads (misma red: sin holgura exigida) y fuera de todo pad. Las 2 de la fila superior (y = 105,017 mm) chocan con la pista RST_LORA de Bottom (y = 105,56 mm; 5 mil frente a 8) y se descartan: **2 vías** en y = 103,606 mm (`F5_u6_ep.py`, `F5_u6ep_anadir.json`; drc y dis: 0 conflictos). El relleno de GND (Top, red GND) cubre la caja de los pads (51,651–55,334 × 102,451–106,159 mm), no más. | Sustituye la propuesta anterior de 4 vías en las esquinas del bloque. D-43 (ninguna vía dentro de un pad) sigue valiendo: estas vías están en los huecos, con máscara por encima. 2 vías en lugar de 4 reducen algo la conducción térmica (el módulo consume ≈ 0,3–0,5 W de pico y ya tiene GND por 3 pines laterales). | **APROBADO por el estudiante (2026-11-01, v5.1 punto 4): relleno de GND en Top y 2 vías en los huecos entre pads.** Menor conducción térmica documentada: 2 vías en lugar de las 4 del land pattern de Espressif (las 2 de la fila superior chocan con RST_LORA de Bottom); el módulo consume ≈ 0,3–0,5 W de pico y tiene GND por 3 pines laterales. Pendiente de colocar tras «GUI LISTA». Detalle en `planificacion\evidencia\F5_v5_noche.md` §6 **[APLICADO el 2/11 18:20–18:26, guardado: 2 vías de GND en (2078, 4079) y (2133, 4079) mil y relleno de GND en Top (2033–2179 × 4033–4180 mil, 3,68 × 3,71 mm sobre los 9 pads del pad térmico; comprobado offline: 0 conflictos y ≥ 183 mil a cualquier otra red). Altium pasa a 1 sola conexión sin rutear (SQW). DRC por grupos: separaciones, cortos, Component Clearance, antenas, vías y agujeros en 0.]** |
| D-50 | **F5 v5: límites eléctricos de los contactos de los relés K1/K2.** | Decisión del estudiante (v5 §1f): contactos de 24 V DC como máximo 30 V DC y 1 A, y 0,5 mm [SUPUESTO] de distancia entre el cobre de contactos y la baja tensión. | El relé SRD-05VDC-SL-C admite 10 A / 30 V DC / 250 V AC en su hoja, pero la placa se declara para ≤ 30 V DC y ≤ 1 A: pistas de contacto de ≥ 30 mil (W_RELAY_CONTACTS 30/40/80 mil; 1 A en 30 mil de 1 oz sobra) y holgura de 20 mil = 0,508 mm entre redes de contactos y cualquier otra (regla C_RELAY_CONTACTS, ya en el DRC sin violaciones). Esa distancia vale para tensiones de seguridad; **no sirve para tensión de red**: va en la nota de verificación física del README de entrega (creepage de relés). | **ACEPTADO [SUPUESTO] (2026-11-01 v5).** |
| D-51 | **F5 v5.1: el set de la esquina USB-C (`F5_p2_usb_cobre.json`) estaba comprobado solo contra pads; contra el registro completo choca con 18 objetos de plano del lote 13 y dejaba sin vía de plano a D7.2 (GND) y C57.1 (V3V3). Rediseñado contra el registro (`F5_usb_reg2.py`).** | Error mío: `F5_A3_usb_barrido.py` y `F5_p2_mil.py` comparan el set con los pads y no con el cobre colocado después (lote 13), y en F5_lotes_1.md §5 y F5_v5_noche.md §7 di «0 conflictos» sin decir contra qué. Contra pads + registro: 43 conflictos con 6 pistas y 5 vías de GND y 5 pistas y 2 vías de V3V3; el primer intento de retirar esos objetos (`F5_usb_reg.py`) dejaba D7.2 y C57.1 sin vía. Rediseño en orden: abanico a mano de los pares → vía de GND de D7.2 en el canal entre las dos columnas de D7 (11,81 / 99,49 mm, pista recta de 1,00 mm) y vía de V3V3 de C57.1 (17,65 / 99,90 mm, pista de 0,84 mm), ambas fuera del pad (D-43) → router para VBUS_USB (17,97 mm, 4 vías), VBUS_SENSE (9,61 mm, 2 vías), CC1 (3,40 mm) y CC2 (3,76 mm) → vías de plano de los demás pads. Resultado offline: 0 conflictos (drc y dis) contra pads con D7/C57 movidos + el resto del registro, 0 ángulos agudos, 7 redes conectadas (USB_DP, USB_DN, VBUS_USB, VBUS_SENSE, CC1, CC2, RSTB), ninguna vía nueva a menos de 1,88 mm de otra red, todos los pads de GND/V3V3 con vía, continuidad de L2 y L3 (mayor componente 100 %, sin astillas > 2 mm²; `F5_planos_usb.py`). Retirar de Altium: 26 pistas y 10 vías de plano; colocar: 79 pistas y 19 vías (`F5_usbreg2_borrar.json`, `F5_usbreg2_anadir.json`). Las vías de retorno de USB_DN se documentan una sola vez en la nota general D-53. | **Aprobado por el estudiante (v5.2 punto 1):** se aplica solo tras «GUI LISTA» con el procedimiento por lote: checkpoint y respaldo, borrado, colocación, verificación, DRC de Component Clearance con 0, `P2_redes` con 128 redes y 658/658 pines y `F5_planos_lotes.py --registro` con L2 y L3 en una sola pieza; detenerse ante cualquier anomalía. Orden: `pcb_move_exact` de D7 y C57 → borrar `F5_usbreg2_borrar.json` → colocar `F5_usbreg2_anadir.json` → `pcb_bind_pad_nets` → verificaciones → `audit_find_signal_vias_without_return` (D-53). | **REDISEÑADO offline y APROBADO (v5.2); colocado tras «GUI LISTA» (ver «APLICADO» más abajo).** Detalle en `planificacion\evidencia\F5_v5_1.md` **[APLICADO el 2/11 18:03–18:18, guardado solo del PcbDoc: D7 a (471, 3917) mil y C57 a (728, 3964) mil, con errores de aterrizaje de −0,28 y +0,24 mil; borradas 26 pistas y 10 vías, colocadas 79 pistas y 19 vías sin fallos; `P2_redes` 128 redes y 658 de 658 pines; L2 y L3 en una sola pieza; DRC por grupos: separaciones, cortos, anchos, vías, agujeros y Component Clearance en 0. Las 6 redes del USB-C quedan completas (15 conexiones). Piezas movidas: 2 de 15. Ver D-53 y D-57.]** |
| D-52 | **F5 v5.1: condición para generar las salidas (Gerber, taladros, BOM, CPL, IPC-356, PDF, STEP, README).** | Decisión del estudiante (v5.1 punto 3, sustituye al punto 1d del v5): el DRC completo con todas las reglas debe dar **0 violaciones, salvo la conexión sin rutear de SQW**, que queda como única excepción documentada (D-46). Cualquier otra violación o conexión sin rutear sigue bloqueando las salidas. | Con SQW sin conectar, el DRC completo mostrará 1 «Un-Routed Net» (SQW, U6.4–U8.7); eso no bloquea. Nada más. | El README de entrega lleva la nota: para usar la salida de 1 Hz, soldar un cable del SQW/OUT del DS1307 (U8, pin 7) al pin 4 de U6 (opcional). | **VIGENTE (2026-11-01 v5.1).** |
| D-53 | **F5 v5.2: nota general sobre las vías de retorno de las vías de señal (regla de 1,88 mm entre redes distintas, D-38).** | **[Era PENDIENTE hasta colocar el USB-C; la medida real se escribió el 2/11 18:19 (ver «CERRADO» más abajo). Lo siguiente es la vista previa offline (`F5_usb_retorno.py`).]** Vista previa: la regla de 1,88 mm entre vías de redes distintas deja 157 de las 159 vías de señal de la placa sin vía de retorno (GND o alimentación) a ≤ 50 mil (1,27 mm); las 3 vías de USB_DN quedan a 2,04, 2,67 y 3,03 mm de la vía de GND más próxima. USB_DP lleva 0 vías (16,65 mm, todo en Top) y USB_DN 3 vías (17,78 mm; 3 pistas en Bottom): diferencia de longitud 1,13 mm. | D-38: antipads de 64 mil en L2 y L3; una vía de GND a ≤ 1,27 mm de una de señal queda siempre a < 1,88 mm de ella, así que no se añade ninguna (v5.1 punto 5, v5.2 punto 3). Argumento: USB 2.0 Full Speed (12 Mb/s) con 10 mil de ancho y ≈ 17 mm de longitud lo tolera: la corriente de retorno cruza entre planos por las vías de plano más cercanas, a 2–3 mm. | **CERRADO el 2/11 18:19 con la medida real** (`audit_find_signal_vias_without_return`, 50 mil, tras colocar el USB-C): 161 vías de señal comprobadas y 152 sin vía de retorno a ≤ 50 mil, por la separación de 1,88 mm entre redes distintas (D-38): una vía de GND a ≤ 1,27 mm de una de señal quedaría a < 1,88 mm. USB_DP: 0 vías, 655,65 mil (16,65 mm), todo en Top. USB_DN: 3 vías, 699,98 mil (17,78 mm); diferencia 44,3 mil = 1,13 mm. Distancia real de las 3 vías de USB_DN a la vía de GND más próxima: 2,67, 3,03 y 2,04 mm (la herramienta solo marca 2 de las 3; por mi geometría las 3 incumplen el criterio de 50 mil y la omisión queda sin explicar). Argumento [SUPUESTO, criterio de ingeniería, no medido]: USB 2.0 Full Speed (12 Mb/s, bit de 83 ns, flancos de 4 a 20 ns) con 1,13 mm de diferencia (≈ 7 ps) y vías de 1,6 mm de largo no es sensible a la falta de retorno inmediato. |
| D-54 | **F5 «GUI LISTA» 2/11: con GND y V3V3 asignadas a L2_GND y L3_PWR, la conectividad de Altium no usa los planos (212 sin rutear: GND 162, V3V3 34).** | [VERIFICADO] Cifras idénticas a las del 1/11 16:01 (antes de la GUI), también tras la recarga del PcbDoc (17:12, hecha por el estudiante con «Don't Save») y tras re-enlazar los 210 pads de GND y V3V3 con `pcb_bind_pad_nets` (17:18, checkpoint `20261102-171736-089272`; netlist intacto: 128 redes, 658 de 658 pines, 690 pads idénticos como conjunto). Los pads pasantes de GND salen sin rutear contra vías y el DRC lista «Split Plane (No Net) on L2_GND / L3_PWR Dead Copper – Net Not Assigned». **Causa localizada en el archivo:** `Polygons6` contiene dos objetos «Split Plane» (PLANE1 y PLANE2, un rectángulo que cubre todo el tablero) **sin clave `NET`**, byte a byte iguales antes y después de la GUI; la GUI solo cambió `PLANE1NETNAME` y `PLANE2NETNAME` en `Board6`. La API no los ve (`pcb_get_polygons` devuelve 0), así que `pcb_modify_polygon` no sirve. | D-39 (PlaneClearance 20→12 mil) no se aplica: no es geometría. Remedio propuesto [SUPUESTO: en este espacio de trabajo no hay ningún PcbDoc con plano y red para comparar el formato]: en el editor PCB, con L2_GND como capa activa, doble clic sobre el plano (región Split Plane) y «Connect to Net» = GND; igual con L3_PWR y V3V3; guardar solo el PcbDoc y repetir `UnRoutedNet` y `NetAntennae`. `F5_verificar_gui.py` debería comprobar también la clave de red de esos dos polígonos (se añade cuando se vea el nombre real de la clave). | **RESUELTA el 2/11 17:35 (GUI 2, regiones Split Plane con red: PLANE1 = GND, PLANE2 = V3V3; guardado solo del PcbDoc).** Medido después: V3V3 34 → 0; GND 162 → 9 (los 9 del pad térmico de U6, cerrados luego con el relleno de D-49); `NetAntennae` 22 → 0; `UnRoutedNet` 212 → 13 líneas (SQW y los pads sin chapar de D-58). `F5_verificar_gui.py` ya comprueba la red de las dos regiones (`regiones_plano`, 10 de 10). |
| D-55 | **F5 «GUI LISTA» 2/11: `NEXUS32.PrjPcb` con cambios sin guardar en Altium.** | El `.PrjPcb` de disco (28/10 23:41:03, 36.245 B) lista 15 documentos; el proyecto vivo tiene 16: sobra `ActiveBOM.VirtualBOM`, documento virtual de Altium que no existe como archivo en disco. Es la única diferencia visible desde fuera. | Decisión del estudiante (opción B): no se guarda el `.PrjPcb` ni se usa `app_save_all` ni `app_checkpoint(save_first=True)`. **Guardado solo del PcbDoc probado y verificado el 2/11 17:22:51:** `obj_run_process` con `WorkspaceManager:SaveObject` y `ObjectKind=Document|FileName=<ruta del PcbDoc>` cambia la hora del PcbDoc y deja el `.PrjPcb` en 28/10 23:41:03 (SHA-256 AE76FDDBF58DA5A6…). Frente al archivo de las 16:37: pistas (2802), vías (358), arcos (60), componentes (220), polígonos (2) y las 48 reglas idénticos; los 690 pads idénticos como conjunto; cambian el orden de los registros, `Connections6` y los flujos de marcas de violaciones del DRC (por eso el archivo pasa de 17.020.928 a 16.791.552 B). | **CERRADO el 2/11 17:22** (opción B; método de guardado verificado). |
| D-56 | **F5 «GUI LISTA» 2/11: DRC por grupos (`F5_drc_grupos.py`); el DRC completo se corta en 500 violaciones y solo devuelve 100.** | Cobre, cortos, anchos, vías y agujeros, Component Clearance y planos/polígonos: **0**. `UnRoutedNet` 218 (212 listadas; 196 son GND y V3V3, D-54), `NetAntennae` 22 (20 vías de plano con una pista y 2 huérfanas sin pista: GND (38,56 / 112,27) mm y V3V3 (37,95 / 110,44) mm), `MinimumSolderMaskSliver` 20 (0,06–3,6 mil), `SilkToSilkClearance` 200, `SilkToSolderMaskClearance` + `SilkToBoardRegionClearance` 437, `DiffPairsRouting` 2 (TPOUT 2241 mil y TPIN 1289 mil sin acoplar frente a 500; es D-48). Reglas restauradas con 0 diferencias de «enabled». | Propuesta al estudiante: documentar como excepción de D-52, además de SQW, las 2 de `DiffPairsRouting`; tratar las de serigrafía como cosméticas (limpiar lo posible con `pcb_autoplace_silkscreen` y `pcb_fix_silk_over_pads` y documentar el residuo); cubrir las vías para las 20 astillas. Ninguna regla se cambia. | **DECIDIDO por el estudiante el 2/11:** D-52 admite como excepciones documentadas SQW sin rutear y las 2 violaciones de `DiffPairsRouting` de los pares Ethernet (D-48); la serigrafía (637) es cosmética solo para el paquete BORRADOR; para el paquete FINAL se intenta limpiar con `pcb_autoplace_silkscreen` y `pcb_fix_silk_over_pads` y se documenta el residuo con su número real. Las vías cubiertas las hace el estudiante (Claude de la GUI) con una regla nueva limitada a vías (`IsVia`, tapadas arriba y abajo): habrá **49 reglas, no 48**; `F5_verificar_gui.py` ya lo acepta (selftest OK). |
| D-57 | **F5 2/11: tercera violación de `DiffPairsRouting`: el par USB queda con 655,65 mil sin acoplar (máximo 500 mil).** | Tras colocar el USB-C (D-51) el DRC por grupos da 3 violaciones en `DiffPairsRouting`: los dos pares Ethernet de D-48 (2241 y 1289 mil) y el par USB (655,65 mil = toda la longitud de USB_DP). Los pads de J8 están entrelazados (B6 DP, A7 DN, A6 DP, B7 DN) y no hay solución plana en una sola capa; USB_DN usa 3 vías (D-48, `F5_pilotos.md` §5). | D-52 solo admite como excepciones SQW y las 2 de los pares Ethernet. Propuesta: admitir también esta tercera (USB 2.0 Full Speed tolera 1,13 mm de diferencia y falta de acoplamiento, D-53) o rediseñar el acoplamiento del par USB (varias horas, sin garantía por el entrelazado de J8). | **ADMITIDA el 2/11 20:28 (decisión del estudiante, por delegación): tercera excepción de `DiffPairsRouting` junto a D-52.** Cifras que se anotan: USB_DP 655,65 mil (16,65 mm) sin acoplar frente al máximo de 500 mil; USB 2.0 Full Speed (12 Mb/s); USB_DN 1,13 mm más largo que USB_DP (≈ 7 ps). No se toca la regla. El informe final cuenta 3 violaciones de `DiffPairsRouting` (2 Ethernet de D-48 y el par USB) y la regla de salidas las trata como D-52 y D-56. |
| D-58 | **F5 2/11: 4 conexiones de GND de pads sin chapar (J8-S1 ×2 y J6-SH ×2) sin resolver.** | Con los planos conectados, el DRC (`UnRoutedNet`) deja 13 líneas: SQW (1) y los pads sin chapar de J8 (S1) y J6 (SH): 4 conexiones y 8 avisos «Unplated Pad». Un pad sin chapar con red GND no se conecta por el plano; Altium lo exige por cobre. `pcb_get_unrouted_nets` solo cuenta SQW. | Opciones: (a) quitar la red GND de los pads sin chapar (edición de librería, son mecánicos y sus gemelos chapados ya llevan GND); (b) unirlos con pistas cortas de GND en Top; (c) admitirlos como excepción. Recomiendo (a) o (c): son guías mecánicas. D-52 no los cubre: bloquean las salidas hasta que se decida. | **ADMITIDA el 2/11 20:28 (decisión del estudiante, por delegación): excepción documentada de las 4 conexiones de GND de J8-S1 ×2 y J6-SH ×2.** Razón: quitar la red exige editar la librería y sincronizar (ECO, prohibido) o editar solo el PCB, lo que rompería `P2_redes` 658 de 658 y la paridad esquemático–PCB; los gemelos chapados ya llevan GND. **Revisión futura (anotada):** esos pads deben ser NPTH sin red en la librería. El informe final cuenta estas 4 conexiones y la regla de salidas las trata como D-52 y D-56. **Que son pads sin chapar está [VERIFICADO] en el archivo guardado con `evidencia\F5_pads_chapado.py` (2/11/2026):** J8-S1 ×2 (24 mil) y J6-SH ×2 (128 mil); junto a MH1-MH4 (D-27) son los 8 pads sin chapar de los 60 con agujero. **RESUELTA en la copia A3 el 6/11 15:03 [VERIFICADO].** Los 4 pads (J8-S1 en (258;3823) y (258;4051) mil; J6-SH en (4696;452) y (5146;452) mil) se renombraron a `0` (como MH1-MH4) y se dejaron sin red, en la librería (`NEXUS32.PcbLib` de la copia, 5/11 15:57) y en la placa (GUI, panel Properties). El ECO por `Update From PCB Libraries` falló al validar (`Cannot match pads with new footprint`) y no se ejecutó; la edición directa deja placa y librería con el mismo nombre de pad. Los gemelos chapados (4 x S1, 2 x SH) conservan GND. Medido antes/después: `UnRoutedNet` 13 -> 1 (solo SQW); resto de grupos sin cambio (0 los que estaban en 0; `DiffPairsRouting` 3, serigrafía 136 y 140); 128 redes, 658 de 658 pines con red correcta, 0 con red distinta, 220/220 componentes; único pad sin pin en el esquemático: `J6.0` y `J8.0`. Textos 466 sin diferencias; `F5_verificar_gui.py` 14 de 14. Detalle: `A3_TRABAJO\FASE2_PADS_SIN_CHAPAR.md`. **AVISO PARA UNA SINCRONIZACIÓN FUTURA (ECO / Update PCB / Update From PCB Libraries):** `J6.0` y `J8.0` (dos pads cada uno, sin chapar y sin red) **no tienen pin en el esquemático**: el símbolo de J6 y el de J8 no tienen pin `0`. `P2_redes` y `F5_sch_vs_pcb.py` los listan como «pad sin pin en el símbolo» (2 avisos): es lo esperado, no un error. No hay que añadir un pin `0` al símbolo ni volver a llamarlos `S1`/`SH` (el ECO les devolvería GND y reaparecerían las 13 filas de `UnRoutedNet`). `Update From PCB Libraries` ya no falla por estos pads porque placa y librería usan el mismo nombre `0`. **Solo vale para la copia A3; `NEXUS32` y `NEXUS32_ENTREGA` conservan la excepción original.** |
| D-59 | **F5 2/11: incidente en J3: `pcb_delete_object` borró el designador «J3» en vez de una nota nueva.** | Al intentar quitar la segunda línea de la nota de J3 (necesaria porque quedó a 0,014 mil de la primera, violación de `SilkToSilk`), la herramienta borró el texto del designador de J3 (a 85 mil de las coordenadas dadas, según ella) y no mi texto. Detectado comparando `Texts6` antes y después (464 → 465: −1 designador de J3, +2 líneas de nota). Los rótulos GND, 3V3, SCL y SDA y «OLED SH1106» siguen intactos. | Respaldo del estado bueno de las 18:32 (con el meandro, sin nota ni incidente): `_respaldos\NEXUS32_2026-11-02_F5-meandro-colocado-1840` (SHA-256 B35FDC03931D749C…). Recuperación propuesta: cerrar la pestaña del PcbDoc con «Don't Save», copiar ese respaldo sobre el archivo y reabrir; después recolocar la nota con separación suficiente y sin borrar nada. `pcb_delete_object` con `object_type=text` no se vuelve a usar. | **CERRADA el 2/11 20:50.** Pestaña del PcbDoc cerrada por la GUI a las 20:28 (sin diálogo de guardar). Copia forense del archivo roto: `_respaldos\NEXUS32_2026-11-02_J3-error-2028` (SHA-256 4B8CEE50…). Restaurado el respaldo de las 18:32 (B35FDC03931D749C…) y reabierto con `WorkspaceManager:OpenObject`. Verificado: `F5_dif_textos.py` «sin diferencias» (464 y 464 textos); `F5_verificar_gui.py` 10 de 10 con 49 reglas; `P2_redes` 128 redes y 658 de 658 pines (0 discrepancias); solo SQW sin rutear; DRC por grupos como a las 18:32 (separaciones, cortos, anchos, Component Clearance, antenas, vías y agujeros = 0; `UnRoutedNet` 13; `DiffPairsRouting` 3; astillas 28). Nota recolocada sin borrar nada, con `pcb_place_text` (TopOverlay, alto 45, giro 90): «VERIFICAR ORDEN» en (2985, 2650) y «ANTES DE ENCHUFAR» en (3062, 2650), separación 77 mil. Checkpoint `20261102-204626-421032` y respaldo `_respaldos\NEXUS32_2026-11-02_J3-restaurado-2048`; guardado solo del PcbDoc (20:46:38 y 20:48:44); `F5_dif_textos.py` tras cada texto: +1 y +2, ningún borrado; serigrafía contra serigrafía 199 y contra otros 437, iguales a la línea base sin nota. Archivo final SHA-256 F3B88CBB…; frente al respaldo bueno solo difieren `Texts6` (+2 textos) y dos marcas de reserialización de Altium al reabrir: `Rules6` (`LAYER` de `SolderMaskExpansion_Vias`, `UNKNOWN` → `TOP`, igual que las otras 48 reglas; alcance, expansión, tapado, prioridad y habilitada no cambian) y `Polygons6` (`SELECTION` del plano L3, `TRUE` → `FALSE`). Pistas, vías, pads, componentes, redes, arcos, rellenos y cuerpos 3D son byte a byte idénticos. `NEXUS32.PrjPcb` intacto (28/10 23:41:03, SHA-256 AE76FDDB…). `pcb_delete_object` con `object_type=text` no se vuelve a usar. |
| D-60 | **F5 2/11: `audit_find_signal_vias_without_return` marca solo 2 de las 3 vías de USB_DN.** | Las 3 vías de USB_DN están a 2,04, 2,67 y 3,03 mm de la vía de GND más próxima, todas por encima de 1,27 mm (50 mil), así que la herramienta debería marcar las 3. Marca 2. | Por decisión del estudiante no se investiga la causa. Vale el cálculo manual de D-53 (las 3 incumplen el criterio de 50 mil) y D-53 sigue cerrada. | **Anotada; sin acción.** |
| D-61 | **F5 3/11: regla `SolderMaskExpansion_FinePitch` (opción B del estudiante, «OK B» del 2/11) para los 28 puentes de máscara por debajo de 4 mil en J8, U1, U10, U11 y U14.** | `MinimumSolderMaskSliver` (4 mil) marcaba 28 pares pad/pad en Top (J8 ×8, U1 ×4, U10 ×4, U11 ×4, U14 ×8) con la expansión general de 2 mil: puente = hueco de cobre − 4 mil = 1,5–3 mil, por debajo del 0,10 mm (3,94 mil) que JLCPCB publica (0,13 mm con máscara negra o blanca). Con expansión 0 el puente es el hueco de cobre (5,5–7,0 mil = 0,14–0,18 mm), mayor que 0,10 y que 0,13 mm, así que el color de máscara no importa; el estudiante deja verde, 1 oz. | Regla nueva (**50 reglas en total** desde ahora; D-56 y D-59 hablan de 49, que era el recuento antes de esta): tipo Solder Mask Expansion, expansión 0 mil arriba y abajo, sin tapado, sin «Solder Mask From The Hole Edge», habilitada, ámbito `InComponent('J8') Or InComponent('U1') Or InComponent('U10') Or InComponent('U11') Or InComponent('U14')`. **Prioridad final:** `SolderMaskExpansion_Vias` 1, `SolderMaskExpansion_FinePitch` 2, `SolderMaskExpansion` (2 mil, All) 3. `SolderMaskExpansion`, `SolderMaskExpansion_Vias` y `MinimumSolderMaskSliver` no se tocaron. En esas cinco piezas la apertura de máscara queda igual que el pad. | **CERRADA 3/11 00:25 [VERIFICADO].** Creada por GUI porque `pcb_create_design_rule` solo admite clearance, width, via_size y differential_pairs (`PCB.pas`, PCB_CreateDesignRule). Guardado solo del PcbDoc con `SaveObject` a las 00:08:50 (SHA-256 285539B5…); antes: checkpoint `20261103-000831-307987` y respaldo `_respaldos\NEXUS32_2026-11-03_FinePitch-previo-0010` (F3B88CBB…, el estado de las 20:48:44). `.PrjPcb` intacto (AE76FDDB…). `pcb_get_design_rules`: 50 reglas habilitadas, prioridades 1, 2 y 3 como arriba. `F5_verificar_gui.py` 12 de 12. **DRC por grupos (`F5_drcg_fp1.json`, antes = 20:42/20:45 y, para polígonos y planos, 18:14):** astillas de máscara **28 → 0**; separaciones 0 → 0, cortos 0 → 0, anchos 0 → 0, vías y agujeros 0 → 0, Component Clearance 0 → 0, antenas 0 → 0, polígonos y planos 0 → 0, `UnRoutedNet` 13 → 13 (SQW y los pads sin chapar de D-58), `DiffPairsRouting` 3 → 3 (D-52 y D-57: 655,65 / 2241,31 / 1289,33 mil), serigrafía contra serigrafía 199 → 199 y contra máscara 437 → 437 (las 100 filas devueltas de cada grupo son idénticas). `P2_redes`: 128 redes, 658 de 658 pines, 0 distintos, solo SQW sin rutear. `F5_dif_textos.py` contra el respaldo previo: sin diferencias (466 textos). Salvedad: `F5_drc_grupos.py` apaga todas las reglas durante cada grupo, también las de máscara; el antes y el después se midieron igual y el archivo solo difiere en la regla nueva, así que el cambio se debe a ella. El script ya incluye la regla en el grupo «resto». **Verificación posterior (3/11, `F5_verificar_lote_silk.py`, archivo de las 20:48:44 frente al de las 00:08:50):** `Pads6` cambia solo en los 92 pads de J8 (18), U1 (17), U10 (14), U11 (14) y U14 (29), en la caché de la expansión de máscara de su registro de geometría, que es la consecuencia de la regla; `Tracks6`, `Arcs6`, `Fills6`, `Vias6`, `Polygons6`, `Regions6`, `ComponentBodies6` y `Components6` idénticos; `Rules6` distinto por la regla nueva. |
| D-62 | **F5 S1 paso A, 3/11: `pcb_autoplace_silkscreen` aceptado por el estudiante pese a que no cumple la condición (d): 35 de los 92 designadores movidos quedan más cerca del cuadro de otro componente que del suyo.** | Las dos herramientas de serigrafía que se nombraron no admiten lotes ni excluir textos (`F5_S1_serigrafia_bloqueo.md`). El estudiante ordenó ejecutar `pcb_autoplace_silkscreen` una sola vez como paso atómico y reversible, con comprobaciones (a)-(e) y restauración si fallaba alguna. Falló (d); tras ver `F5_vistas\despues_autoplace` escribió «OK A» el 3/11 y anuló la restauración. | 220 designadores recorridos (`placed 105, skipped 115`); **92 cambian de posición**, todos en rotación 0° (lista, desplazamientos y resultado de (d) por designador en `F5_S1_pasoA_movidos.csv`). Desplazamiento del ancla: mediana 208 mil, máximo 939 (K2), 89 de 92 por encima de 100 mil. **Los 35 de (d), con el componente que les queda más cerca entre paréntesis:** Y1(BT1), TP23(K1), TP18(C24), TP1(U1), R72(K2), R69(TP23), R61(Q1), R53(C41), R51(J6), R49(R48), R48(D6), R25(U6), R20(R18), R11(R22), R8(SW2), F1(J2), D9(R72), D2(J2), D1(F1), C49(C46), C43(Y2), C41(U12), C40(C39), C38(C37), C32(R26), C30(C29), C28(SW5), C25(R20), C23(Q1), C22(SW1), C15(U4), C14(C18), C13(L2), C8(R6), C4(U2). Se miden con una caja de texto estimada (0,65 × altura por carácter) y el cuadro del componente = pads + contorno de serigrafía; con el ancla la cifra es 41. **Corrección posterior (3/11, modelo de caja de texto calibrado con el panel Messages: avance 0,90 × alto por carácter y caja 1,10 × alto, en lugar de la estimación inicial de 0,65):** los designadores que no cumplen (d) son **41 de 92** y no 35; la lista actualizada, con el componente más cercano, está en `F5_S1_pasoA_movidos.csv`. Los 35 de arriba son los de la estimación inicial. Quedan sin tocar hasta que el estudiante diga cuáles le parecen ambiguos; el paso B (`obj_modify` sobre `eTextObject`, piloto de 1 texto y lotes de ≤ 10) queda en reserva para esos o para los que sigan pisando pads tras S2. | **CERRADA y ACEPTADA el 3/11 por el estudiante («OK A»).** **Serigrafía, antes → después:** contra serigrafía **199 → 136**; contra máscara y región **437 → 341**. **Línea base nueva** (`F5_drcg_baseC5B9.json`, 10:02-10:12, archivo de las 09:50:10, SHA-256 c5b9517e…): separaciones 0, cortos 0, anchos 0, vías y agujeros 0, Component Clearance 0, antenas 0, astillas de máscara 0, polígonos y planos 0, `UnRoutedNet` 13, `DiffPairsRouting` 3; reglas restauradas sin diferencias. `F5_verificar_gui.py` 12 de 12; `P2_redes` 128 redes, 658 de 658 pines, 0 con red distinta, solo SQW sin rutear; `F5_dif_textos.py` sin diferencias (466 textos) frente a la copia previa. **Verificación independiente de Claude de la GUI** (archivo guardado frente a la copia previa 285539B5…): `Tracks6`, `Arcs6`, `Fills6`, `Pads6`, `Vias6`, `Polygons6`, `Regions6`, `ComponentBodies6`, `Nets6` y `Classes6` idénticos byte a byte; `Texts6` con 466 registros, 92 cambian solo en X, Y y la caché de posición (8 últimos bytes), ningún texto ni capa cambia; 464 a 0° y 2 a 90° (las dos líneas de la nota de J3, sin tocar). **Mi verificación** (`F5_verificar_lote_silk.py`): (a) streams idénticos salvo `Rules6` (solo `LAYER` de `SolderMaskExpansion_FinePitch`, `UNKNOWN` → `TOP`, reserialización de Altium) y `Components6` (solo `NAMEAUTOPOSITION` en 92 componentes); (b) y (c) cumplen; (d) no cumple. **Punto de retorno previo a D-62:** `_respaldos\NEXUS32_2026-11-03_autoplaceA-previo-0948` (285539B5…) y checkpoint `20261103-094811-092436`; copia del resultado en `_respaldos\NEXUS32_2026-11-03_autoplaceA-resultado-0950` (c5b9517e…). |
| D-63 | **F5 S2, 3/11: `SilkToSolderMaskClearance` baja de 10 a 5,91 mil (0,15 mm), con el OK por escrito del estudiante.** | 5,91 mil son los 0,15 mm de distancia mínima de serigrafía a pad que publica JLCPCB (sección Legend); Altium mide hasta la apertura de máscara, que es el pad más 2 mil en general y el pad exacto en las 5 piezas FinePitch (D-61), así que 5,91 a la apertura son 5,91 mil o más al pad. No se eligió 6 porque 7 filas medían justo 6,0 mil y con una regla de 6 habrían pasado por el filo. Con 10 mil, 196 de las 341 filas (todos los 192 contornos de huella) estaban ya a 6 mil o más. | Solo cambia el valor mínimo (campo `MINSILKSCREENTOMASKGAP`, «Silkscreen To Object Minimum Clearance»); ámbito `IsPad`, «All» en el segundo objeto y «Check Clearance To Exposed Copper» igual que antes. **No se tocaron** `SilkToSilkClearance` (10 mil), `SolderMaskExpansion_FinePitch`, `SolderMaskExpansion_Vias` ni ninguna otra regla; siguen 50 reglas. | **CERRADA 3/11 12:26 [VERIFICADO].** La API no escribe esta regla: la cambió Claude de la GUI (10 mil → `5.91mil`, sin redondeo al reabrir). Guardado solo del PcbDoc con `SaveObject` a las 12:11:36 (SHA-256 5f3a65f8…); `.PrjPcb` intacto (AE76FDDB…). Punto de retorno: checkpoint `20261103-111647-993153` y `_respaldos\NEXUS32_2026-11-03_S2-previo-1117` (c5b9517e…). **Serigrafía, antes → después:** contra máscara **341 → 143**; contra serigrafía 136 → 136 (regla sin tocar). Separaciones, cortos, anchos, vías y agujeros, Component Clearance, antenas, astillas de máscara y polígonos y planos: 0 → 0; `UnRoutedNet` 13 → 13; `DiffPairsRouting` 3 → 3 (`F5_drcg_s2.json`, 12:17-12:26; reglas restauradas sin diferencias). `F5_verificar_gui.py` 14 de 14 (ahora comprueba la regla de 5,91 mil y la de serigrafía contra serigrafía en 10); `P2_redes` 128 redes, 658 de 658 pines, 0 con red distinta, solo SQW sin rutear; `F5_dif_textos.py` sin diferencias (466 textos) frente a la copia previa. Frente a la copia previa: `Tracks6`, `Arcs6`, `Fills6`, `Pads6`, `Vias6`, `Polygons6`, `Regions6`, `ComponentBodies6` y `Components6` idénticos; en `Rules6` cambia solo `MINSILKSCREENTOMASKGAP` (10mil → 5.91mil). Difieren, sin que cambie el diseño, `Board6` (+19 B), `Nets6` (4 redes ganan campos de caché: `DELAYTOTAL`, `ROUTEDLENGTH`), `Design Rule Checker Options6`, `PrimitiveGuids`, el flujo de marcas de violación de serigrafía (67 986 → 3 075 B) y, en los 466 registros de `Texts6`, 36 bytes de caché (offsets 80-109 y 173-179) con X, Y, rotación, texto, capa, altura, ancho y componente iguales. **Residuo esperado:** el archivo del panel Messages de las 09:50 da 144 filas por debajo de 5,91 mil (130 de texto y 14 de arco); el DRC mide 143 (una menos, sin explicar [PENDIENTE]; la fila más cercana al límite es J3 pad 3 con el rótulo SCL, a 5,901 mil). Las 130 filas de texto vienen de **61 textos: 57 designadores y los 4 rótulos de J3 (GND, 3V3, SCL, SDA)**; son el alcance del paso B. **Los 14 arcos se aceptan como residuo de la geometría de librería** (arcos de contorno de huella que tocan el pad; no se arreglan moviendo textos y corregirlos exigiría editar la librería y un ECO, prohibido): C12, C14, C2, C20, C22, C31, C41, C57, D4, R31, R61, R62, R66 y R71 (12 en 0 mil, uno a 2 mil y uno a 3,5 mil). Los 192 contornos de huella (pistas) pasan, entre 6,00 y 9,97 mil. |
| D-64 | **F5 S1 cierre, 3/11: residuo de serigrafía contra máscara, 140 filas (57 designadores y 14 arcos), aceptado como excepción documentada.** | `obj_modify` no persiste la posición de un designador: Altium la reconstruye desde los 8 últimos bytes del registro de texto y esa herramienta no los actualiza (prueba de recarga del 3/11 13:05: los 9 designadores del lote 1 volvieron a su posición original; los rótulos libres de J3 sí persisten). Un handler nuevo exigiría editar y desplegar el script del puente justo antes del congelado y necesita el OK escrito del estudiante, que no lo da. Mover los textos a mano por la GUI no cabe en el tiempo. Los 14 arcos son la marca de pin 1 de la huella, geometría de librería: corregirla exigiría editar la librería y un ECO, prohibido. | **Antes → después, serigrafía contra máscara:** 437 → 341 (autoplace, D-62) → 143 (D-63, 5,91 mil) → **140** (rótulos de J3 movidos); **contra serigrafía:** 199 → 136 → 136. **Por tipo (140 filas):** texto 126 (115 en 0 mil, 8 entre 0 y 3,9 mil y 3 entre 3,9 y 5,91 mil), arco 14 (12 en 0 mil, uno a 2,0 y uno a 3,5 mil), contorno de huella 0 (las 192 filas de contornos de la lista de las 341 miden de 6,00 a 9,97 mil y pasan). Los 4 rótulos de J3 ya no están en el residuo. **Designadores con filas (57):** C2, C3, C4, C8, C14, C20, C21, C23, C24, C28, C35, C36, C38, C40, C46, C49, C50, C51, C53, C55, C56, C57, D1, D4, D6, D7, D10, D12, D13, D14, D18, R1, R6, R7, R9, R10, R14, R16, R24, R31, R34, R37, R38, R40, R55, R57, R62, R63, R67, R70, TP10, TP11, TP12, TP18, U1, U2 y U3; la separación real, el número de filas y los pads afectados de cada uno están en `evidencia\F5_D64_residuo_serigrafia.csv`. **Arcos de marca de pin 1 (14 filas en 14 componentes):** C2, C12, C14, C20, C22, C31, C41, C57, D4, R31, R61, R62, R66 y R71. | **ACEPTADA el 3/11 por el estudiante (decisión por delegación).** Fuente: panel Messages copiado por la GUI (`F5_msgs_silk_mascara_final.txt`, 140 filas numeradas 1-140) tras el último DRC por grupos (13:17) sobre el archivo guardado a las 13:11:53 (SHA-256 63744a39…); cuenta con `F5_msgs_silk_cuenta.py`. **Efecto en fabricación: [PENDIENTE]:** la página de JLCPCB (Legend) solo publica 0,15 mm de distancia mínima de serigrafía a pad y no dice qué hace con la serigrafía que cae sobre un pad; las 115 filas de texto en 0 mil y las 12 de arco en 0 mil son serigrafía sobre pad. `SilkToSilkClearance` sigue en 10 mil con 136 filas, sin tocar. |
| D-65 | **F5 BOM/CPL 3/11: los 23 puntos de prueba (TP1–TP23) llevan pasta de soldar (capa `GTP`) y se queda así.** | `F5_gerber_check.py`: `GTP` trae 630 aperturas = 630 pads SMD de Top, de los que 23 son los TP. La pasta solo estaña esos pads: siguen accesibles a la sonda. Quitarla exigiría tocar la placa (aperturas de pasta o la regla de pasta de esos pads) después del congelado de reglas. | Los TP no son piezas del CPL (sin MH ni TP en `CPL_JLCPCB.csv`); JLCPCB imprimirá pasta en ellos y los dejará estañados. Efecto en la medida con la sonda: ninguno esperado [SUPUESTO]. | **ACEPTADA el 3/11 por el estudiante (decisión por delegación).** |
| D-66 | **F5 BOM/CPL 3/11: 9 designadores quedan fuera del contorno de la placa en la capa `GTO` (MH1, MH2, MH4, U6, J2, J4, J5, J8, J9), aceptados como residuo estético.** | `F5_gerber_check.py`: `GTO` tiene 102 coordenadas fuera del perfil, todas de esos 9 textos. Moverlos exigiría que `obj_modify` persistiera la posición de un designador, y no lo hace (D-64, prueba de recarga del 3/11 13:05). No se mueve nada. | Texto de serigrafía sin función fuera de la placa. Qué hace JLCPCB con la serigrafía fuera del perfil no está documentado: **[PENDIENTE]**; se revisa con la vista previa de JLCPCB que traiga el estudiante. | **ACEPTADA el 3/11 por el estudiante (decisión por delegación).** |
| D-67 | **F5 BOM 3/11: D1, D2 y D4 = SS56, LCSC C18199169 (la fila de `01_TRAZABILIDAD_componentes.csv` seguía en SS54, MDD, C22452).** | D-19 ya cambió el diodo a SS56 y la placa y los esquemáticos guardados lo llevan: comentario SS56 en D1, D2 y D4 en `BOM_BORRADOR.csv` y, en los `.SchDoc`, LibReference, Comment y MPN = SS56. La fila de la tabla se alineó con D-19 (diodo, límites, código y stock con fecha). Catálogo de JLCPCB el 3/11 15:40: C18199169 extendida y preferida, stock 1 156 916, 60 V, 5 A, V_F 700 mV @ 5 A. | Pasa de básica (SS54) a extendida (SS56). **Cosmético pendiente:** la descripción del componente en el símbolo y los esquemáticos aún dice «Diodo Schottky 40V 5A SMA (MDD SS54)»; corregirla exige editar la librería y los esquemáticos, prohibido hoy; no entra en el BOM de JLCPCB (usa Comment, Footprint y LCSC). | **ACEPTADA el 3/11 por el estudiante (decisión por delegación).** |
| D-68 | **F5 BOM 3/11 (ampliado): colores de los LED (D5 rojo KT-0603R C2286, D10 verde KT-0603G C12624, D11 amarillo XL-1608UYC-04 C965803) y resolución de las 30 líneas del BOM sin código con consulta al catálogo de JLCPCB: las 31 líneas resultantes (la de 100 kΩ se divide en dos) quedan con código, 4 de ellas con el umbral de stock bajado.** | Ningún documento (`DESVIACIONES.md`, `03_DECISIONES.md`, `02_ANALISIS_CIRCUITO.md`) asigna color a D5, D10 y D11; los planes de F3 ya usan esas tres piezas en ese orden, igual que la tabla de trazabilidad. Reglas del estudiante: básicas primero, stock > 10 000, R al 1 % salvo donde `02_ANALISIS` exija otra (0,1 % en R1, R2, R3, R27, R30, R33, R36 y R28, R31, R34, R37), C X7R/X5R con V ≥ 2 × riel, 10 µF en 0805 y 1210 por tensión y stock. La línea de 100 kΩ se divide en dos (0,1 % en R27, R30, R33 y R36; 1 % en R5, R6, R8, R9, R13, R66 y R71), por eso las 30 líneas pasan a 31. **Umbral de stock bajado para 4 líneas (decisión del estudiante, 3/11, solo para ellas):** R1 590 kΩ C861479 (stock 7132), R2 60,4 kΩ C861495 (9803), R3 30,1 kΩ C855794 (4732) y R28, R31, R34 y R37 de 43,2 kΩ C861404 (5419). Ninguna pieza de 0603 al 0,1 % llegaba a 10 000; con 1 % se ensancharían los umbrales de OVP y UVLO del TPS26600; el stock cubre lo que hace falta (5, 5, 5 y 20 unidades para 5 placas [SUPUESTO]). Verificado por consulta de catálogo por código (3/11 15:54 a 15:58, guardada en `evidencia\F5_busquedas_jlc_2026-11-03.jsonl`): los cuatro son 0603, del valor exacto, ±0,1 %, película fina (Yageo). Cada código sale de una consulta guardada con fecha; la tabla completa, con tolerancia, tensión, huella, tipo y stock, en `F5_bom_resolucion_2026-11-03.csv` y los candidatos descartados en `F5_bom_candidatos_2026-11-03.csv`. | Extendidas distintas: 35 → **52** (73 códigos: 21 básicas y 52 extendidas, 2 de ellas preferidas). Las 4 de umbral bajado son extendidas y con stock ajustado: si JLCPCB se queda sin alguna el día del pedido, la línea vuelve a [PENDIENTE]. **Corrientes de los LED** (1 kΩ en serie, Vf del rango de la hoja de datos): D5 0,9–1,5 mA a 3,3 V (1,2 mA con 2,1 V), D10 1,9–2,4 mA y D11 2,6–3,2 mA a 5 V [VERIFICADO: hojas de KT-0603R, KT-0603G y XL-1608UYC-04]. **D5 puede verse tenue** (hasta 0,9 mA con Vf de 2,4 V): aceptado sin cambiar valores. | **ACEPTADA el 3/11 por el estudiante (decisión por delegación), incluidas las 4 líneas de umbral bajado y el brillo de D5.** |
| D-69 | **F5 BOM 3/11: C4 y C5 (10 µF, 1210) = C337485, 50 V X7R, aceptados.** | Riel VIN_PROT: 24 V nominal y OVP a 27 V. 50 V cumple el doble de 24 V (48 V) pero **no** el doble de 27 V (54 V). El TVS SMBJ28A recorta en 45,4 V (V_C a 13,3 A), por debajo de 50 V. Entre las piezas X7R o X5R de 1210 con stock > 10 000 ninguna pasa de 50 V: las X7R de 63 V y 100 V que devolvió el catálogo tienen 6522, 5759 y 4706 unidades. Existe una de 100 V **X7S**, C576517 (GRM32EC72A106KE05L, stock 60 814), que queda fuera de la regla X7R/X5R del estudiante. | El efecto de la tensión de polarización sobre la capacidad (una cerámica de 10 µF pierde capacidad con la tensión continua) no está medido ni se ha leído la curva de la pieza: **[SUPUESTO]**. Pieza extendida. | **ACEPTADA el 3/11 por el estudiante (decisión por delegación).** **5/11: cambio a C576517 (Murata GRM32EC72A106KE05L, 100 V X7S) evaluado y NO aplicado.** Condición de precio: 0,6624 USD frente a 0,3396 de C337485 con 10 unidades (5 placas), relación 1,95: cumple; con 1 unidad 0,7458 frente a 0,3396, relación 2,20: no cumpliría. Condición de grosor: la hoja de Murata da T máx. 2,7 mm para esa pieza (código de espesor E) y el cuerpo 3D de C4 y C5 en la placa mide 98 mil = 2,49 mm (`R3_cuerpos.json`): **no cumple** (2,7 > 2,49). Se queda C337485. |
| D-70 | **A3 6/11 (copia `A3_TRABAJO`): los tres `DiffPairsRouting` (USB 655,65 mil, TPOUT 2241,31 mil, TPIN 1289,33 mil; máximo 500 mil) se dejan como excepción MEDIDA; D-48, D-52 y D-57 siguen vigentes.** | **Regla:** `DiffPairsRouting` con hueco Mín = Máx = Preferido = **10 mil** y ancho 8 / 12 / 14 mil; `NetAntennae` con tolerancia **0 mil**. Altium da 0 mil acoplados en los tres pares (cifra reportada = largo de USB_DP, de TPOUT_N y de TPIN_N). En USB ya existían tramos paralelos con hueco de 10,00 mil junto a J8 (53 + 30 + 30 mil) y uno de 136 mil a 9-10 mil junto a U14 y no contaban: lo que cuenta es un tramo largo y limpio. **USB, un intento (6/11 15:10-15:55):** tramo de **176 mil** a **10,000 mil** de hueco con extremos alineados (DP deja y = 3954 en x = 560 y baja a 45° a (616, 3898); DN horizontal en y = 3878 con un codo de 2 mil), comprobado offline contra pads, pistas y vías reales sin conflictos DRC. Resultado en Altium: `DiffPairsRouting` **3 -> 2** (el par USB desaparece) pero `NetAntennae` **0 -> 2** (USB_DP, pistas de 79,196 y 44 mil); re-enlazar los 10 pads de USB (`pcb_bind_pad_nets`) no lo arregló. Se **revirtió**: lectura completa de la placa con 2864 pistas, 369 vías y 690 pads idénticos a la previa y DRC de vuelta a antenas 0 y `DiffPairsRouting` 3. Causa de las antenas: **[SUPUESTO, no verificado]** desajuste mínimo en la unión (560, 3954) al mover extremos con `obj_modify`, que con tolerancia 0 cuenta como antena. **Ethernet, sin intento:** faltan por acoplar unos **1741 mil de TPOUT_N (de 2241)** y **789 mil de TPIN_N (de 1289)**. En el cobre actual TPOUT no tiene ningún tramo P-N a menos de 60 mil de hueco y TPIN tiene un solo tramo paralelo de 184 mil a 42 mil de hueco. El orden de pads cambia a lo largo del camino (en TPIN: N queda a 50 y 74 mil por debajo de P en U12 y D6, 158 mil al este en R49/R50 y al NE a (150, 100) mil en J6), y las **24 combinaciones de M2** con el router de pares (solo Top, sin vías) dieron **0 mm** acoplados (D-48). [ESTIMACIÓN, no medida] sin mover piezas ni rehacer el lote 8 el acoplamiento alcanzable en TPIN es del orden de 300-400 mil, menos de los 789 necesarios. | Decisiones del estudiante (por delegación, 6/11): **no hacer un segundo intento en USB** (la idea pendiente era borrar y colocar pistas nuevas con extremos idénticos), **no mover piezas** para Ethernet (D6, R47-R50, J6; D-48 opción a) y **no continuar con las fases 4 y 5**. No se toca la regla `DiffPairsRouting` ni los anchos. | **CERRADA como excepción medida (6/11 16:20).** Violaciones de `DiffPairsRouting`: 3 antes y 3 después. Detalle: `A3_TRABAJO\FASE3_PARES_DIFERENCIALES.md`. **ACTUALIZACIÓN R2 (6/11 16:54-17:45): USB RESUELTO en la copia A3.** Segundo intento con las pistas borradas y colocadas de nuevo con `pcb_place_tracks` y extremos idénticos (tramo de 176 mil a 10,000 mil): `NetAntennae` 0, `DiffPairsRouting` 3 -> 2, resto de grupos sin cambio; PcbDoc `86DC6825`. La causa de las antenas del primer intento era mover extremos con `obj_modify` (tolerancia 0 mil). **Cómo mide Altium:** longitud sin acoplar de una pista = su largo en Top menos el largo acoplado (hueco 10,000 mil), no el tramo continuo; condición `largo - acoplado <= 500` en cada pista. Experimento TPIN: un tramo acoplado de 184 mil bajó TPIN de 1289,334 a 1131,844 (revertido). TPIN_N necesita >= 789 mil acoplados y TPOUT >= 1741; el router offline (TPOUT_P siguiendo a TPOUT_N) dio una ruta de 1926 mil, 0 conflictos y **0 mil acoplados**. Quedan 2 violaciones de `DiffPairsRouting` (TPOUT 2241,311 y TPIN 1289,334) como excepción medida; D-48 y D-52 vigentes. Detalle: `A3_TRABAJO\R2_FASES_2_3_4.md`. Solo vale para la copia A3; `NEXUS32` y `NEXUS32_ENTREGA` no cambian. |
| D-71 | **A3 7/11 (copia `A3_TRABAJO`): la serigrafía NO se trabajó; el paquete de fabricación A3 se entrega con la serigrafía tal cual: silk contra silk 136 y silk contra máscara 140 filas (los 57 designadores de D-64 y los 14 arcos de pin 1).** | **Decisión del estudiante, por delegación, 7/11:** ejecutar solo la Fase 6 (paquete de fabricación) y cancelar las Fases 4 y 5, sin aplicar ningún parche binario al `.PcbDoc` y sin tocar serigrafía ni arcos. **Contexto técnico:** `obj_modify` no persiste la posición de un designador (D-64); la única vía persistente hallada fue parchear a mano los streams `Texts6` (posición, altura 40 mil, giro, caché de centro) y `Components6` (`NAMEON=FALSE` para ocultar), con el archivo cerrado. **No hay lista de designadores ocultos:** el solver de posiciones de la ronda 2 calculaba mal los obstáculos cercanos (función `cerca_obst`, ya corregida en `herramientas\silk_solver.py` pero no relanzada) y sus cifras («94 en conflicto, 88 con posición limpia, 0 a ocultar») son **inválidas**; ninguna se aplicó. El tope de 4 h de la ronda 2 venció el 6/11 a las 20:39. Los 14 arcos de pin 1 siguen siendo geometría de librería (D-64). | **Efecto en fabricación: [PENDIENTE]**, igual que en D-64 (la página de JLCPCB no dice qué hace con la serigrafía sobre un pad). Ningún designador queda oculto: todos siguen impresos y legibles donde estaban; el CPL y el BOM no cambian. Sin variación en las demás medidas: clearance, cortos, anchos, vías y agujeros, Component Clearance, antenas, astillas de máscara y planos siguen en 0. Si se retoma: el modelo de serigrafía calibrado (`silk_modelo.py`, reproduce los 57 textos que marca Altium), el escritor OLE (`ole_patch.py`, probado byte a byte) y el solver corregido están en `A3_TRABAJO\herramientas`; el estado exacto está en `A3_TRABAJO\R2_FASE4_ESTADO.md`. | **Cerrada sin cambios en la copia A3** (excepción documentada, mismo estado que D-64). |
