AlejandroRuiz444/-nexus32-esp32-pcb/MANIFIESTO.md

# NEXUS32_ENTREGA_A3 - manifiesto

Generado 2026-11-07 20:35 por `F6_entrega_a3.py --real` desde `A3_TRABAJO\NEXUS32` (el original NEXUS32, el respaldo y NEXUS32_ENTREGA no se tocaron). 125 archivos, 219.6 MB, mas este manifiesto (`MANIFIESTO.csv` y `MANIFIESTO.md`). SHA-256 de cada archivo en `MANIFIESTO.csv`.

`NEXUS32.PcbDoc` SHA-256 86dc6825b9cc13e311113e57b5a9fb231b72487856be0da0d28ad1612706c4d1

`NEXUS32.PrjPcb` SHA-256 ae76fddbf58da5a6ca3bfb50ac66e27ad6f5a2415b5bf86a5a12e8926362c8ac

## Excluidos

| Ruta | Razon |
|---|---|
| History (25 archivos) | copias automaticas de Altium, no son parte del proyecto |
| Manufacturing/BORRADOR_2026-11-03 (27 archivos) | salidas de fabricacion de la placa ORIGINAL (63744A39); sustituidas por Manufacturing\A3_2026-11-07, generadas de esta placa (86DC6825) |
| NEXUS32.canvas.json | archivo auxiliar del lienzo, fuera de la lista del estudiante |
| NEXUS32__01_INPUT_POWER.SchDoc | hoja suelta que no esta en el proyecto (no aparece en el .PrjPcb) |
| NEXUS32__01_INPUT_POWER_r2.SchDoc | hoja suelta que no esta en el proyecto (no aparece en el .PrjPcb) |
| NEXUS32__02_POWER_REGULATION.SchDoc | hoja suelta que no esta en el proyecto (no aparece en el .PrjPcb) |
| NEXUS32__02_POWER_REGULATION_r2.SchDoc | hoja suelta que no esta en el proyecto (no aparece en el .PrjPcb) |
| NEXUS32__03_ESP32_CORE.SchDoc | hoja suelta que no esta en el proyecto (no aparece en el .PrjPcb) |
| NEXUS32__03_ESP32_CORE_r2.SchDoc | hoja suelta que no esta en el proyecto (no aparece en el .PrjPcb) |
| NEXUS32__04_I2C_EEPROM.SchDoc | hoja suelta que no esta en el proyecto (no aparece en el .PrjPcb) |
| Project Logs for NEXUS32 (2 archivos) | registros de Altium, no piden entrega |
| Project Outputs for NEXUS32 (26 archivos) | salidas de Altium (informes DRC y copias de trabajo); las salidas de fabricacion estan en Manufacturing\A3_2026-11-07 |
