AlejandroRuiz444/-nexus32-esp32-pcb/Manufacturing/A3_2026-11-07/JLCPCB_SUBIDA/BOM_JLCPCB.csv

Comment | Designator | Footprint | LCSC Part #
CR2032 | BT1 | BAT-HLD-001 | C7501066
47nF | C1 | R_0603 | C1622
1uF | C2,C14,C17,C18,C23,C29 | R_0603 | C1592
100nF | C3,C6,C7,C12,C16,C19,C22,C24,C25,C26,C27,C28,C30,C31,C32,C33,C34,C35,C36,C37,C38,C39,C40,C42,C43,C44,C45,C46,C47,C48,C53,C55,C57 | R_0603 | C1591
10uF | C4,C5 | C_1210 | C337485
150pF | C8 | R_0603 | C1594
22uF | C9,C10,C13,C20,C52 | C_0805 | C29277
10uF | C11,C58 | C_0805 | C440198
10uF | C15,C21,C41,C51 | R_0603 | C19702
18pF | C49,C50 | R_0603 | C1647
4.7uF | C54,C56 | R_0603 | C19666
SS56 | D1,D2,D4 | D_SMA | C18199169
SMBJ28A | D3 | D_SMB | C178227
LED usuario | D5 | LED_0603 | C2286
SRV05-4.TCT | D6 | SOT-23-6_SRV05-4 | C13612
USBLC6-2SC6 | D7 | SOT-23-6_USBLC6 | C7519
1N4148W | D8,D9 | D_SOD-123 | C81598
LED rele 1 | D10 | LED_0603 | C12624
LED rele 2 | D11 | LED_0603 | C965803
BAT54S | D12,D13,D14,D15,D16,D17,D18,D19 | SOT-23-3_DBZ | C47546
2 A / 63 V | F1 | F_1206 | C3105
BLM21PG221SN1D | FB1 | FB_0805 | C85840
24 VDC | J1 | TB_KF128-5.08-2P | C474952
BATERIA 12 V | J2 | TB_KF128-5.08-2P | C474952
OLED SH1106 | J3 | HDR_1x4_P2.54_F | C2718488
ENTRADAS 0-10 V | J4 | TB_DB127S-5.08-5P | C2997522
ENTRADAS 0-3.3 V | J5 | TB_DB127S-5.08-5P | C2997522
HR911105A | J6 | RJ45_HR911105A | C12074
ANTENA 915 MHz | J7 | UFL_R_SMT_1 | C88373
TYPE-C-31-M-12 | J8 | USB-C_TYPE-C-31-M-12 | C165948
CONTACTOS K1 | J9 | TB_KF128-5.08-3P | C474953
CONTACTOS K2 | J10 | TB_KF128-5.08-3P | C474953
RELE 1 | K1 | RELAY_SRD-05VDC-SL-C | C35449
RELE 2 | K2 | RELAY_SRD-05VDC-SL-C | C35449
22uH | L1 | L_SRP7050TA | C1332438
2.2uH | L2 | L_NRS4018 | C92959
S8050-J3Y | Q1,Q2 | SOT-23-3_DBZ | C2146
AO3400A | Q3,Q4 | SOT-23-3_DBZ | C20917
590k 0.1% | R1 | R_0603 | C861479
60.4k 0.1% | R2 | R_0603 | C861495
30.1k 0.1% | R3 | R_0603 | C855794
11.8k | R4 | R_0603 | C22861
100k 0.1% | R27,R30,R33,R36 | R_0603 | C122538
100k 1% | R5,R6,R8,R9,R13,R66,R71 | R_0603 | C25803
22.1k | R7,R57 | R_0603 | C2960862
210k | R10 | R_0603 | C2933168
40.2k | R11 | R_0603 | C2933218
453k | R12 | R_0603 | C3013202
10k | R14,R15,R19,R20,R21,R22,R23,R25,R39,R41,R43,R45,R53,R54,R61,R62,R64,R69 | R_0603 | C25804
499 | R16 | R_0603 | C2933227
4.7k | R17,R18 | R_0603 | C23162
1k | R24,R26,R29,R32,R35,R38,R40,R42,R44,R56,R67,R72 | R_0603 | C21190
43.2k 0.1% | R28,R31,R34,R37 | R_0603 | C861404
2.32k | R46 | R_0603 | C2933173
49.9 | R47,R48,R49,R50 | R_0603 | C23185
330 | R51,R52,R63,R68 | R_0603 | C23138
0 | R55 | R_0603 | C21189
47.5k | R58 | R_0603 | C23061
5.1k | R59,R60 | R_0603 | C23186
2.2k | R65,R70 | R_0603 | C4190
RESET | SW1 | SW_TS-1187A | C318884
BOOT | SW2 | SW_TS-1187A | C318884
ARRIBA | SW3 | SW_TS-1187A | C318884
ABAJO | SW4 | SW_TS-1187A | C318884
OK | SW5 | SW_TS-1187A | C318884
TPS26600PWPR | U1 | HTSSOP-16-EP_PWP_P0.65 | C544399
MP1584EN-LF-Z | U2 | SOIC-8-EP_MP1584 | C15051
TLV62569DBVR | U3 | SOT-23-5_DBV | C141836
TLV75533PDBVR | U4 | SOT-23-5_DBV | C404027
REF3033AIDBZR | U5 | SOT-23-3_DBZ | C36658
ESP32-WROOM-32E-N4 | U6 | ESP32-WROOM-32E | C701341
AT24C256C-SSHL-T | U7 | SOIC-8_3.9x4.9_P1.27 | C6482
DS1307Z+ | U8 | SOIC-8_3.9x4.9_P1.27 | C1520446
MCP3208-CI/SL | U9 | SOIC-16_3.9x9.9_P1.27 | C16939
TLV9004IPWR | U10,U11 | TSSOP-14_PW_P0.65 | C2058050
ENC28J60-I/SO | U12 | SOIC-28W_7.5x17.9_P1.27 | C47351
Ra-01H | U13 | MODULE_Ra-01H | C503593
CP2102N-A02-GQFN28R | U14 | QFN-28-EP_5x5_P0.5 | C964632
PC817X2CSP9F | U15,U16 | SOP-4_PC817X_L10.16 | C66405
32.768 kHz | Y1 | XTAL_MC-146 | C15482
25 MHz | Y2 | XTAL_3225_4P | C9006
