AlejandroRuiz444/-nexus32-esp32-pcb/(list of files, cad)

Other CAD files:
Manufacturing/A3_2026-11-07/3D/NEXUS32.step
