AlejandroRuiz444/-nexus32-esp32-pcb/Manufacturing/A3_2026-11-07/JLCPCB_SUBIDA/CPL_CORRECCIONES.md

# CPL — tabla de correcciones (placa A3, 86DC6825)

Aquí van **solo** los ajustes de rotación o posición del CPL que salgan de la vista previa de JLCPCB (capturas del análisis de fabricación y de la vista previa del montaje que traiga el estudiante). La placa no se toca por esto.

| Designador | Rotación o posición original | Rotación o posición corregida | Razón | Referencia de JLCPCB |
|---|---|---|---|---|
| (sin correcciones todavía) | | | | |
