AlejandroRuiz444/-nexus32-esp32-pcb/(list of files, drawings)

Other design files:
00_TOP_LEVEL.SchDoc
01_INPUT_POWER.SchDoc
02_POWER_REGULATION.SchDoc
03_ESP32_CORE.SchDoc
04_I2C_EEPROM.SchDoc
05_I2C_RTC.SchDoc
06_I2C_OLED.SchDoc
07_SPI_ADC.SchDoc
08_SPI_ETHERNET.SchDoc
09_SPI_LORA.SchDoc
10_UART_USB.SchDoc
11_DIGITAL_OUTPUTS.SchDoc
NEXUS32.PcbDoc
NEXUS32.PrjPcb
